NivLC/lava_jato/README.md

# Limpador ultrassônico

Esse projeto é um sistema de limpeza ultrassônica usando piezoelétricos para vibrar a água com frequência ajustável. O desenvolvimento foi divido em quatro etapas:

- [Etapa 1](./etapa_1/README.md) (10/09/2026): Fazer as pesquisas necessárias e dar início ao esquemático do projeto.
- [Etapa 2](./etapa_2/README.md) (01/10/2026): Projetar cada bloco de forma isolada, testá-los planejar a integração.
- [Etapa 3](./etapa_3/README.md) (05/11/2026): Desenvolvimento, montagem e teste do protótipo.
- [Etapa 4](./etapa_4/README.md) (10/12/2026): Ajustes finais para otimização.

## Requisitos

**(Adicionar aqui os requisitos de hardware e software.)**

Este projeto foi implementado com os seguintes módulos/softwares/hardwares:

- Sensor de temperatura PT100 com 3 fios.
- Sensor de corrente de efeito Hall LEM LA 205-S.
- Espressif IoT Development Framework (esp idf).
- Microcontrolador STM32F401.

## Visão geral

**(Adicionar aqui diagrama de blocos com UM parágrafo de explicação resumida de cada bloco (Ex.: 1 linha cada bloco).)**

**A figura deve estar com um tamanho adequado para melhorar a apresentação da página inicial do projeto.**

## Protótipo

**(Adicionar aqui uma foto do protótipo com UM parágrafo de explicação.)**

**A figura deve estar com um tamanho adequado para melhorar a apresentação da página inicial do projeto.**
