NivLC/lava_jato/etapa_2/README.md

# Etapa 2 - Design

Na etapa 2, objetiva-se:
- Detalhar a topologia escolhida na etapa 1;
- Caracterizar o piezoelétrico;
- Decidir Interface de controle;
    - Estudar possibilidade de trava de segurança;
- Definir design externo do recipiete;
- Escolher microcontrolador;
- Testes.

## Topologia 4: Fonte externa + Casamento de impedância

Por ser composta por um transformador *push-pull* que permite a conversão de energia através do casamento de impedância entre o primário e secundário, com apenas de duas chaves *low-side* para realizar a comutação, a topologia 4 é a mais adequada.  
Utilizando PWM e *timer*, o controle de potência é possível por tensão e/ou frequência, conforme Figuras 1 e 2.

<div align=center>
<h5>Figura 1: Topologia escolhida</h5>
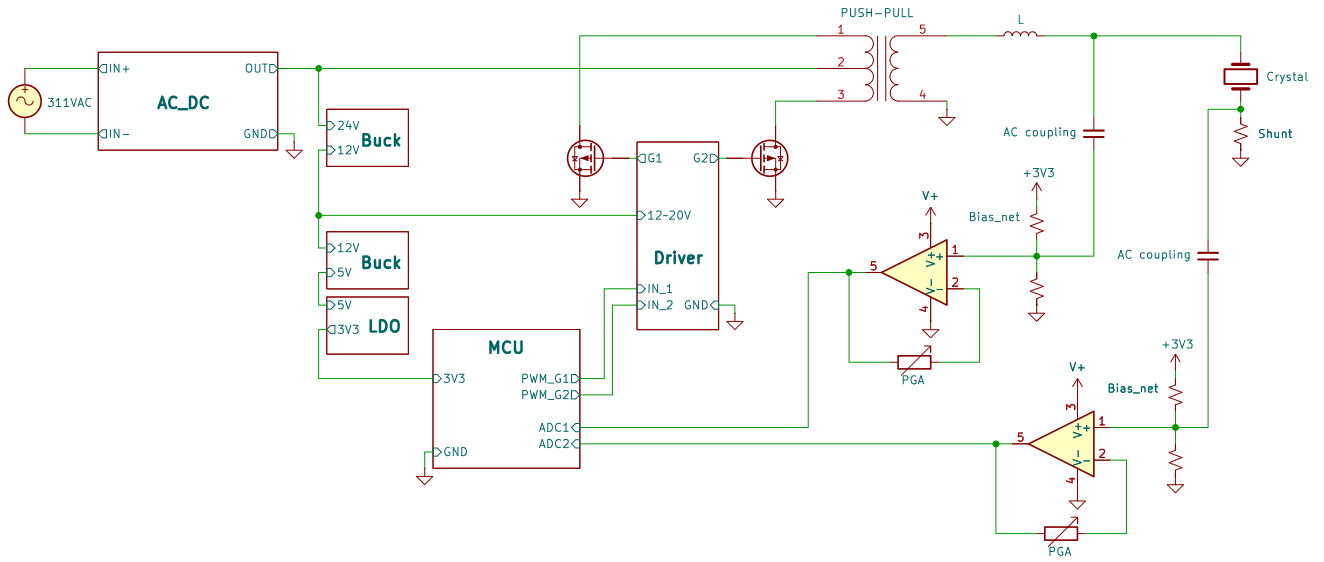
[picture p27: etapa_2/img/push-pull.png]

</div> <br>

<div align=center>
<h5>Figura 2: Timer e PWM</h5>
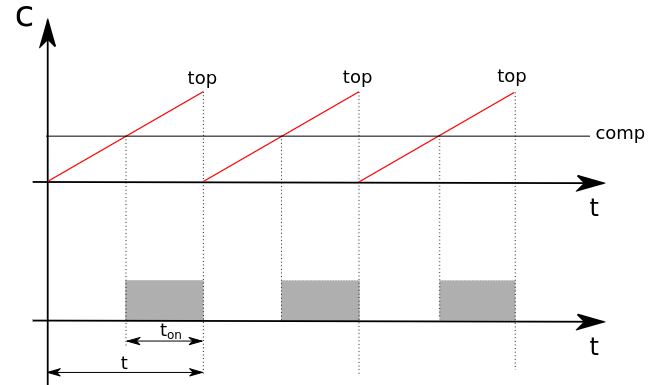
[picture p28: etapa_2/img/pwm-timer.png]

</div> <br><br>

O cristal pode ser considerado uma carga capacitiva. Com corrente constante, a tensão no capacitor é linear, portanto há um controle fino do movimento.

<div align=center>
<h5>Figura 3: Corrente constante X Tensão constante no capacitor</h5>
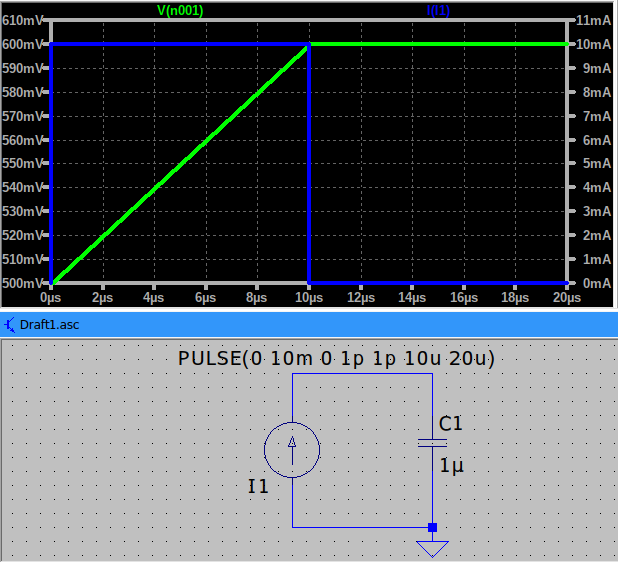
[picture p29: etapa_2/img/cap_curr.png]

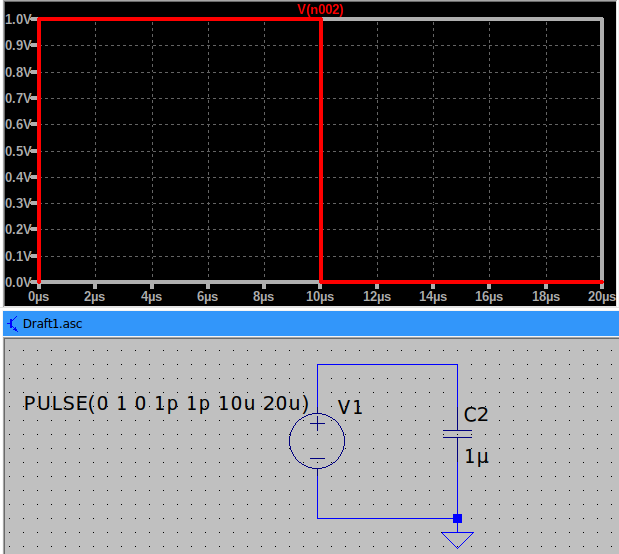
[picture p30: etapa_2/img/cap_volt.png]

</div> <br><br>

Como mencionado na Etapa 1, é possível adicionar um indutor em série no *tap* central do *push-pull* para fazer uma fonte de corrente. No entanto, o indutor tipicamente é grande e pode gerar picos de tensão altos na comutação das chaves.

Neste projeto, não há necessidade de controle fino da vibração, portanto podemos simplificar o projeto com fonte de tensão.

A fonte usada para a alimentação será de 24V/5A:

<div align=center>
<h5>Figura 4: Fonte externa</h5>
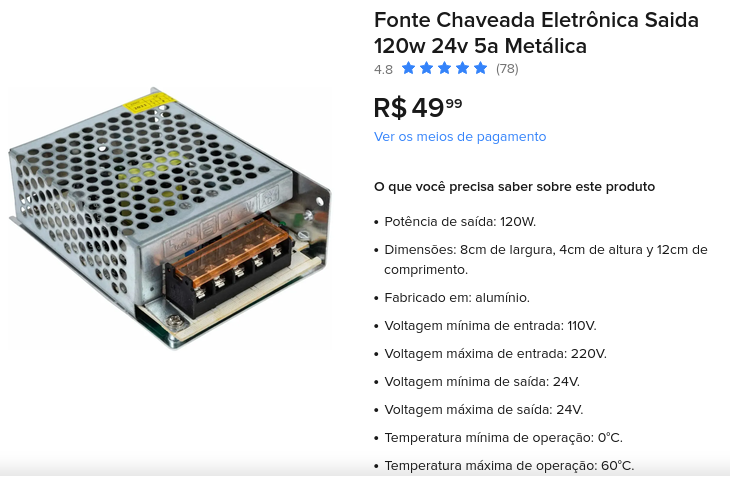
[picture p31: etapa_2/img/fonte.png]

</div> <br><br>

## Caracterização do cristal

Em um cristal piezoelétrico, o comportamento dinâmico é caracterizado por modos de vibração fundamentais: 
- Radial(planar): frequência governada pelo diâmetro, operando em faixas mais baixas (kHz);
- Axial(espessura): frequência governada pela espessura do componente, operando em frequências mais altas (MHz).

A tabela abaixo sumariza os modos de vibração e suas respectivas aplicações. Chamamos a atenção para "*Area expansion mode*" (radial) e "*Thickness expansion mode*" (axial).

<div align=center>
<h5>Figura 5: Modos de vibração do cristal</h5>
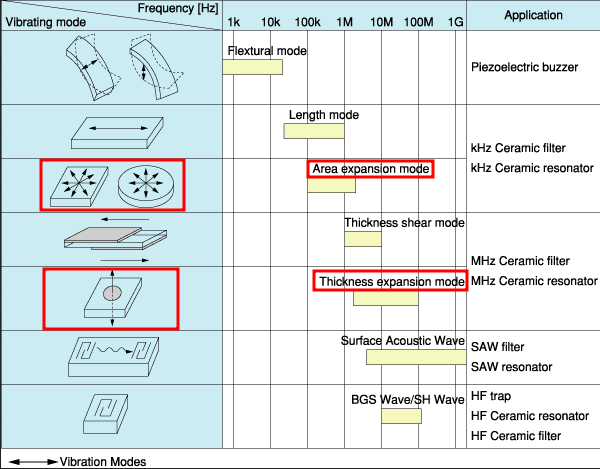
[picture p32: etapa_2/img/vibration.png]

</div> <br><br>

O modo que visamos trabalhar é o **radial**. O modo axial, por conta de sua frequência de operação muito elevada, é melhor aproveitado em aplicações como atomizadores e umidificadores.

Para caracterizar o cristal, utilizamos um osciloscópio com o seguinte *setup*:

<div align=center>
<h5>Figura 6: Diagrama de conexões para caracterizar o cristal</h5>
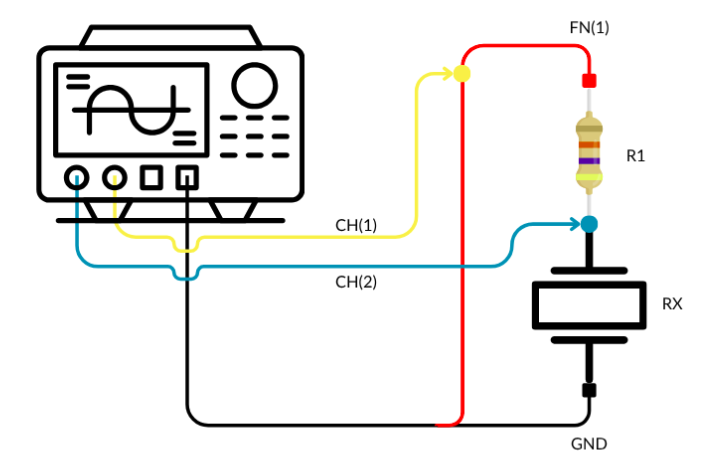
[picture p33: etapa_2/img/caracterizacao.png]

</div> <br><br>

Para equilibrar o divisor de tensão, usamos resistores próximos a impedância estimada do cristal.

O fabricante garante que o cristal tem uma impedância de ressonância inferior a $20 \Omega$, portanto, usamos resistores de $51.2 \Omega$ e $3279 \Omega$ para encontrar, respectivamente, a impedância de ressonância e anti-ressonância em ambos os modos axial e radial de acordo com a fórmula do divisor de tensão:

$$ V_{CH2} = V_{CH1} \frac{R_{cristal}}{R_{cristal} + R1} $$
<br>

### Cristal em aberto

#### Frequências do cristal

Primeiramente, obtivemos informações de frequência apenas com o resistor de $51.2 \Omega$ conectado, sem o cristal. Assim, podemos observar a influência do componente na medição do cristal.

>OBS: Há alguns momentos em que a medição no osciloscópio falha, ocasionando vales bruscos não característicos do sistema real. Essas medições estão identificadas como "nan" nos arquivos .csv disponíveis em [hardware/bode](etapa_2/hardware/bode).

<div align=center>
<h5>Figura 7: Bode Plot com cristal desconectado</h5>
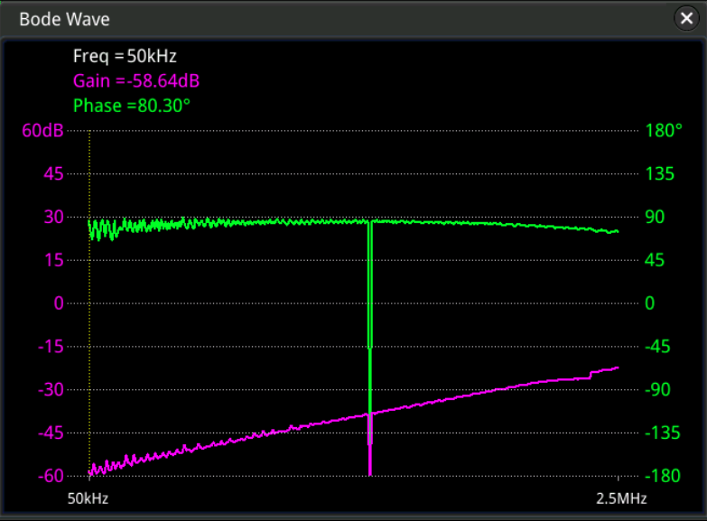
[picture p34: etapa_2/img/setup_bode.png]

</div><br>

Exceto pelo erro de medição, o resistor não aparenta influenciar em demasia o sistema.

Agora,  as informações de frequência para cada resistor.

- Resistor de $3179 \Omega$

    <div align=center>
    <h5>Figura 8: Bode Plot de banda completa</h5>
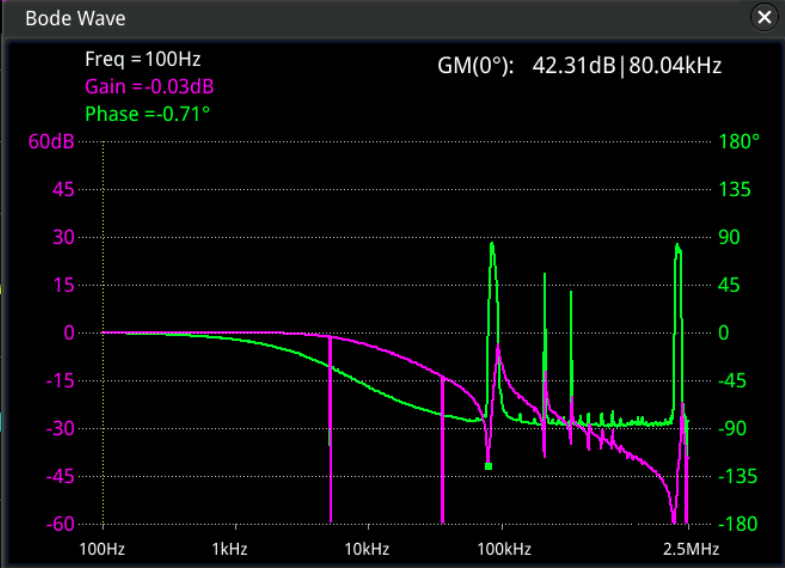
[picture p35: etapa_2/img/R3k_bode_full.png]
    
    </div>

    <div align=center>
    <h5>Figura 9: Bode Plot com zoom no modo axial</h5>
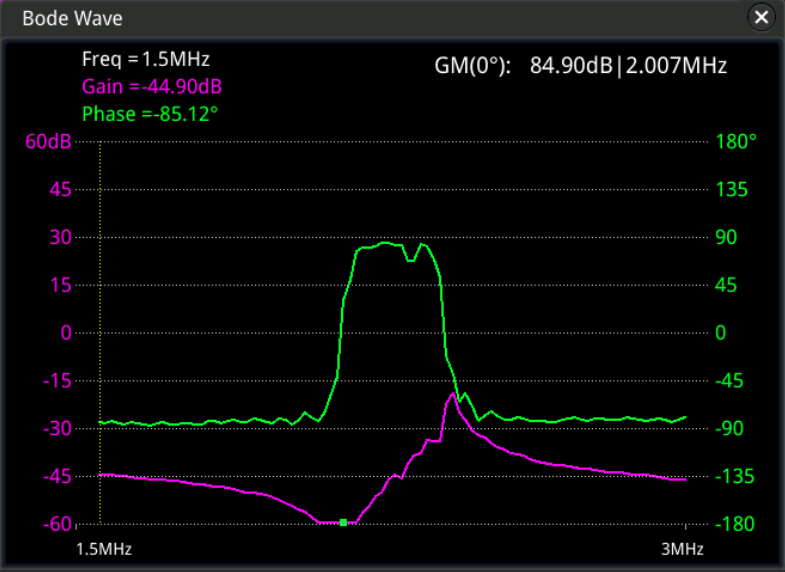
[picture p36: etapa_2/img/R3k_axial_bode.png]
    
    </div>

    <div align=center>
    <h5>Figura 10: Bode Plot com zoom no modo radial</h5>
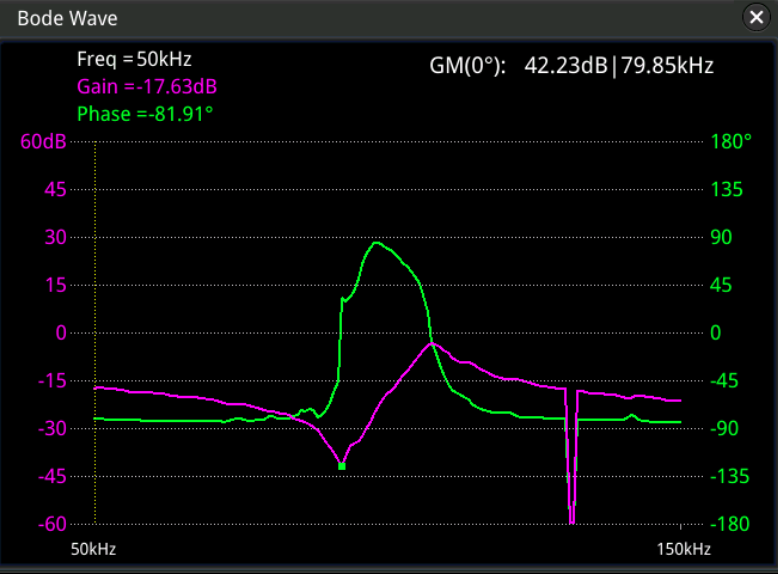
[picture p37: etapa_2/img/R3k_radial_bode.png]
    
    </div>

<br>

- Resistor de $51.2 \Omega$

    <div align=center>
    <h5>Figura 11: Bode Plot de banda completa</h5>
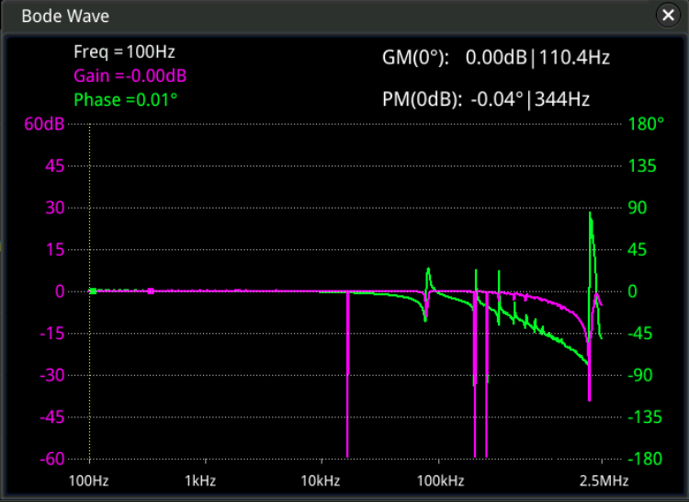
[picture p38: etapa_2/img/R51_bode_full.png]
    
    </div>

    <div align=center>
    <h5>Figura 12: Bode Plot com zoom no modo axial</h5>
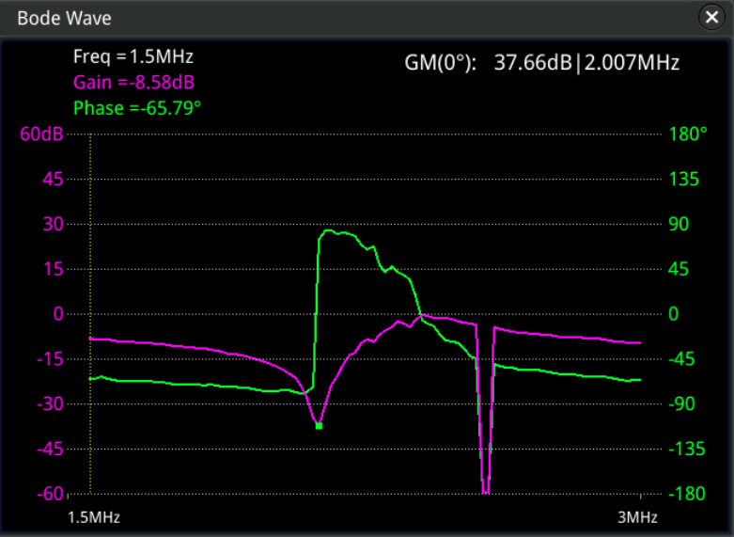
[picture p39: etapa_2/img/R51_axial_bode.png]
    
    </div>

    <div align=center>
    <h5>Figura 13: Bode Plot com zoom no modo radial</h5>
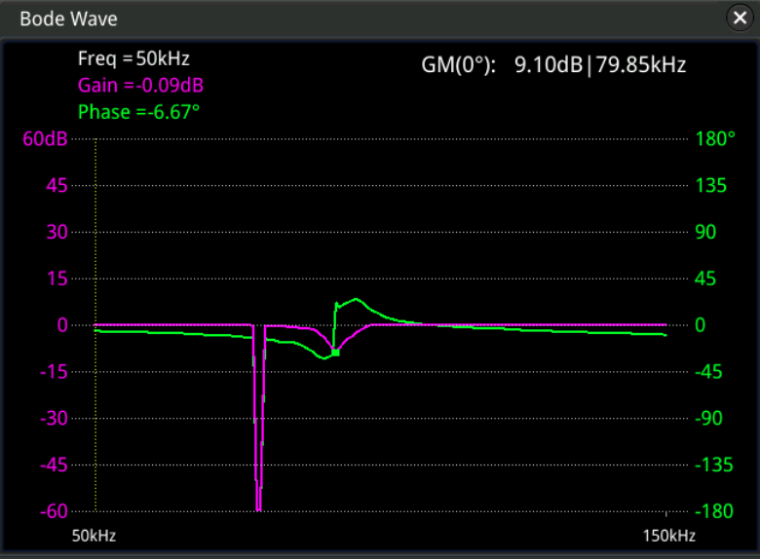
[picture p40: etapa_2/img/R51_radial_bode.png]
    
    </div>

#### Impedância do cristal

Obtendo os valores de $V_{CH1}$ (Vamp1) e $V_{CH2}$ (Vamp2) pelo osciloscópio:

<div align=center>
<h5>Figura 14: Resistor de 51.2Ω (Modo AXIAL)</h5>
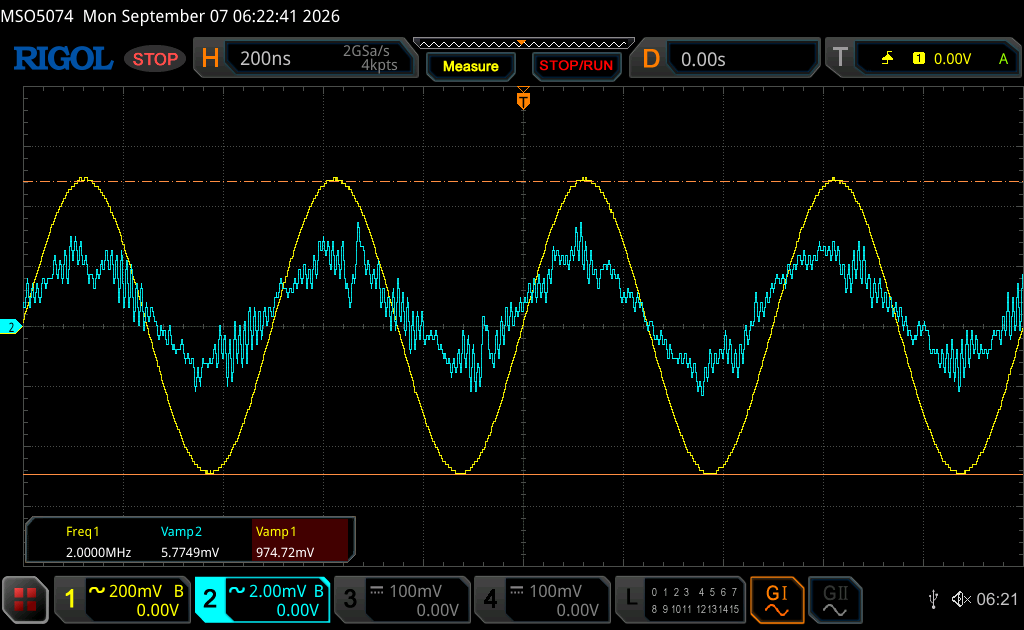
[picture p41: etapa_2/img/R51_axial.png]

</div>

<div align=center>
<h5>Figura 15: Resistor de 51.2Ω (Modo RADIAL)</h5>
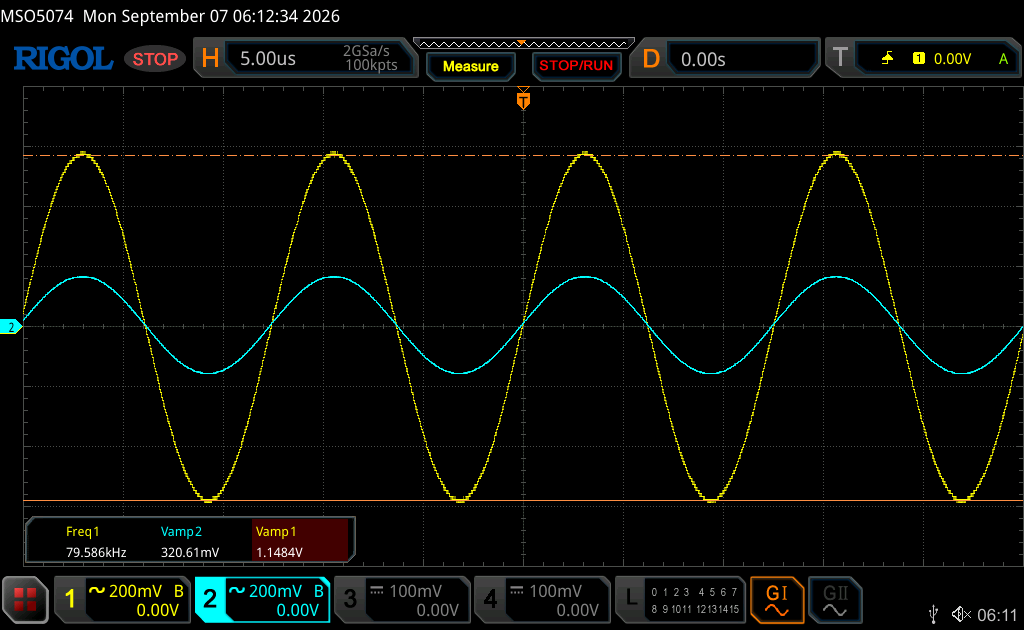
[picture p42: etapa_2/img/R51_radial.png]

</div>

<div align=center>
<h5>Figura 16: Resistor de 3279Ω (Modo AXIAL)</h5>
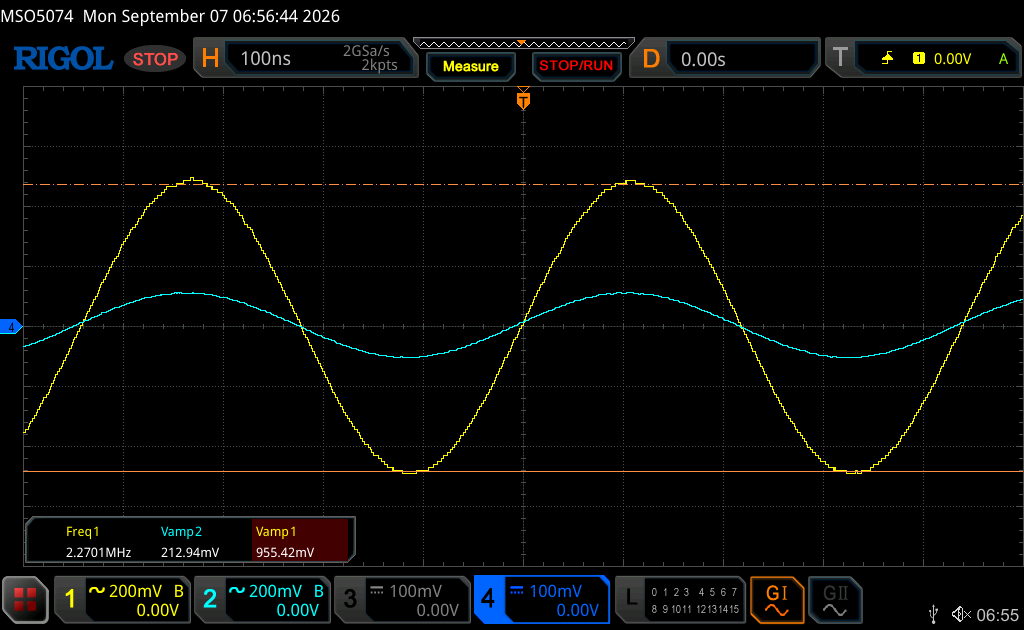
[picture p43: etapa_2/img/R3k_axial.png]

</div>

<div align=center>
<h5>Figura 17: Resistor de 3279Ω (Modo RADIAL)</h5>
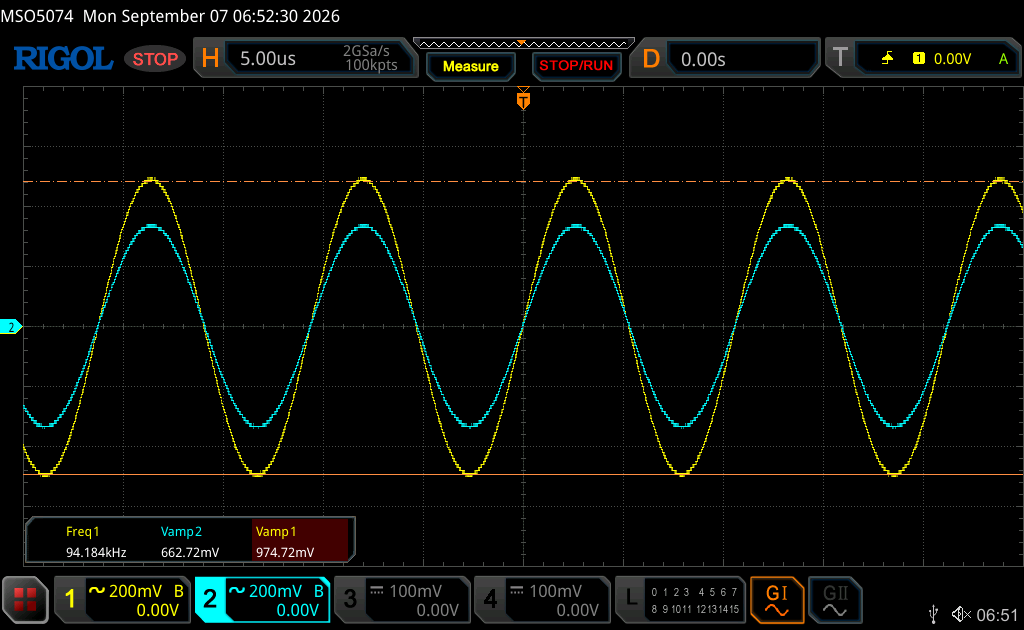
[picture p44: etapa_2/img/R3k_radial.png]

</div><br><br>

Com os valores de tensão conhecidos, podemos calcular o divisor de tensão para $R_{\mathrm{cristal}}$.

### Modo AXIAL

**Ressonância**

$$
0.0057744 = 0.97472 \cdot
\frac{R_{\mathrm{cristal}}}{R_{\mathrm{cristal}} + 51.2}
\qquad \rightarrow \qquad
R_{\mathrm{cristal}} = 0.305\ \Omega
$$

**Anti-ressonância**

$$
0.21294 = 0.95542 \cdot
\frac{R_{\mathrm{cristal}}}{R_{\mathrm{cristal}} + 3279}
\qquad \rightarrow \qquad
R_{\mathrm{cristal}} = 940.402\ \Omega
$$

### Modo RADIAL

**Ressonância**

$$
0.32061 = 1.1484 \cdot
\frac{R_{\mathrm{cristal}}}{R_{\mathrm{cristal}} + 51.2}
\qquad \rightarrow \qquad
R_{\mathrm{cristal}} = 19.8301\ \Omega
$$

**Anti-ressonância**

$$
0.66272 = 0.97472 \cdot
\frac{R_{\mathrm{cristal}}}{R_{\mathrm{cristal}} + 3279}
\qquad \rightarrow \qquad
R_{\mathrm{cristal}} = 6964.93\ \Omega
$$

#### Capacitância

O fabricante disponibiliza uma tabela de valores padrão para o cristal dependendo do tamanho.

O valor da capacitância de placa padrão é de $6940 \pm 15 \% \text{ pF}$. Este valor condiz com o medido com multímetro, de aproximadamente $6.241 \text{ nF}$.

<div align=center>
<h5>Figura 18: Informações do fabricante</h5>
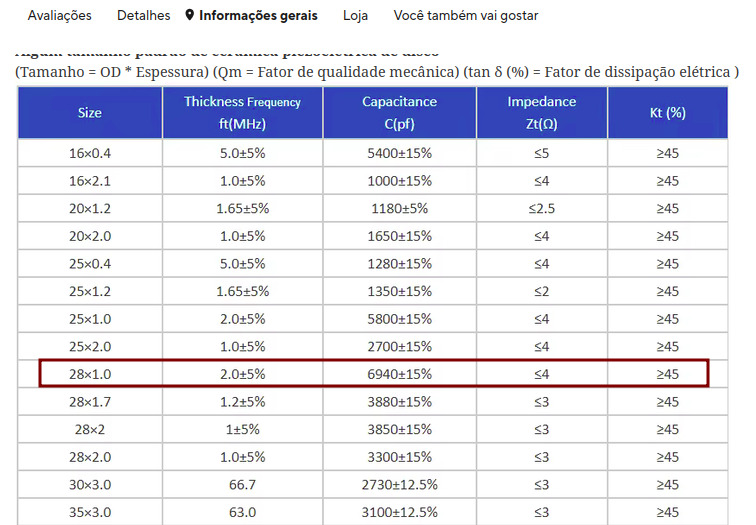
[picture p45: etapa_2/img/fabricante.jpeg]

</div> <br><br>

#### Resultados

Para o modo radial, temos os seguintes resultados:

| Parâmetro | Valor |
|:---|:---|
| Ressonância | 79.85 kHz |
| Anti-ressonância | 94.54 kHz |
| Impedância na ressonância | 19.8301Ω |
| Impedância na anti-ressonância | 6964.93Ω |
| Capacitância de placa | 6.241 nF |

## Interface de controle

Para a interface de controle, optou-se por utilizar um *encoder* rotativo em conjunto com um display(OLED SSD1306 128x64 5V), que servirão de base para a interface humano-máquina.

### Trava de segurança

A resistência mecânica ao movimento do piezoelétrico gera uma variação na impedância enxergada pela corrente que passa por ele, o que leva a uma variável incômoda: a corrente será maior do que o esperado se a bacia estiver vazia, o que pode queimar o transdutor. Uma simples tela de confirmação é o suficiente para garantir que o usuário não ligue o sistema sem água na bacia. Uma mensagem deverá aparecer para o usuário confirmar que a bacia está cheia e que o usuário gostaria de prosseguir ou se deseja cancelar a operação.

## Design externo do recipiente

A cuba interna precisa ser de INOX, e é mostrada na **Figura 19**.

<div align=center>
<h5>Figura 19: Tela em fibra de vidro</h5>
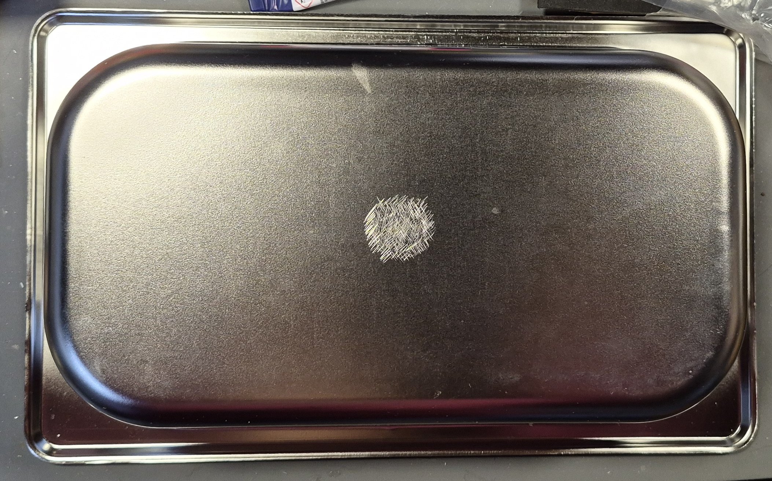
[picture p46: etapa_2/img/fixacao.jpeg]

</div><br>

Já a cestinha interna deve ser vazada, com área de abertura suficiente para que a onda ultrassônica, propagando-se na água, consiga atravessar. Além disso, encontrar uma cestinha inox que se ajuste à nossa cuba é um empecilho grande.  
O comprimento de onda é dado por:

$\lambda=c/f$ ,    c a velocidade da onda na água  
$\lambda=1500/40k$  
$\lambda=37,5 mm$  

Considerando essas informações, decidiu-se fabricar a cestinha a partir da tela mostrada na **Figura 21**, feita em fibra de vidro revestida por teflon.

<div align=center>
<h5>Figura 20: Tela em fibra de vidro</h5>
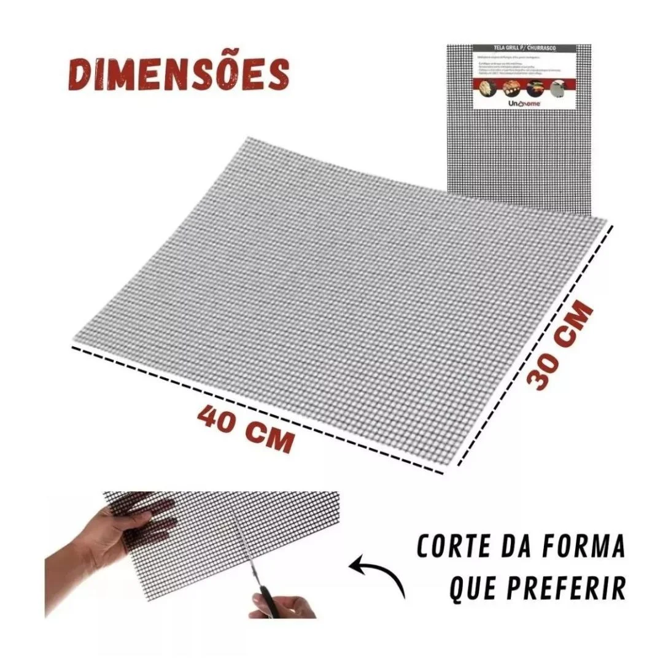
[picture p47: etapa_2/img/tela.webp]

</div><br>

Onde o vão da tela é de $4mm$, ~9 vezes menor que o $\lambda$. Além disso, optou-se por fabricar a carenagem externa impressa em 3D, levando-se em consideração a interface de controle decidida anteriormente.

## Escolha do embarcado

A seguinte tabela resume a análise de requisitos, comparando diferentes microcontroladores:

<div align=center>
<h5>Figura 21: Comparação entre microcontroladores</h5>
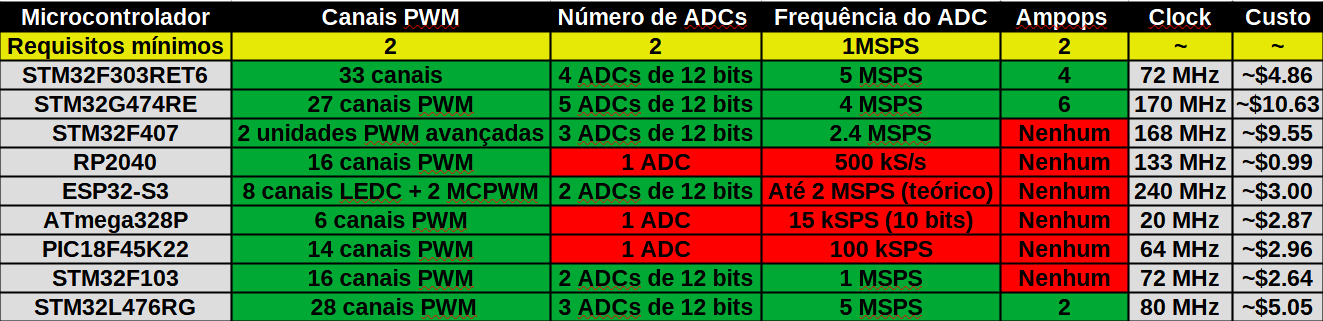
[picture p48: etapa_2/img/microcontrolador.png]

</div><br>

O requisito de frequência de amostragem foi obtido com base no critério de Nyquist(2~4x maior que a de comutação).  
O embarcado escolhido para esta aplicação foi o **STM32F303RET6**, possuindo:

- 4 ADCs de 0.14 MHz a 72 MHz;
- 4 AMPOPs internos.

<div align=center>
<h5>Figura 22: Microcontrolador escolhido</h5>
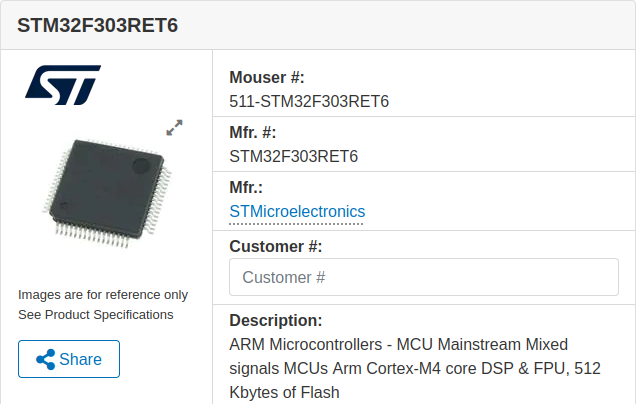
[picture p49: etapa_2/img/stm.png]

</div>

<div align=center>
<h5>Figura 23: Features do microcontrolador</h5>

</div>

## Testes

Para a realização dos testes, foi fabricada uma PCB. A documentação detalhada se encontra em [hardware/README.md](etapa_2/hardware/README.md).

### *Display* e *encoder*

O teste feito usa o *encoder* para incrementar/decrementar um contador, enquanto uma bola quica. Ao pressionar o botão, a cor do *display* muda e a bola sofre uma força de sentido contrário.

O código está disponível em [software](etapa_2/software).

<div align=center>
<h5>Figura 24: Teste display + encoder</h5>

</div>

### Configuração de *timer* e PWM (Sem *driver*)

Para o teste, seguimos a seguinte configuração do TIMER 1 com ARR = 1440:

| Channel | Mode | CCR/Pulse |
| --- | --- | ---: |
| CH1 | Combined PWM1 | 0 |
| CH2 | PWM1 (No output) | 500 |
| CH3 | Combined PWM1 | 720 |
| CH4 | PWM1 (No output) | 1220 |

<br>
<div align=center>
<h5>Figura 25: Combined PWM Mode 1</h5>

</div><br>

No modo *Combined PWM mode 1*, o referência é o OR dos sinais PWM, ou seja, o maior valor entre os canais. Neste caso, CH1|CH2 e CH3|CH4. 
Para calcular o *duty cycle*:

- CH1 | CH2

$$ D = \frac{CCR_{max}}{ARR} \qquad \rightarrow \qquad D = \frac{500}{1440} \approx 34.7\% $$

<br>
<div align=center>
<h5>Figura 26: Duty do CH1</h5>
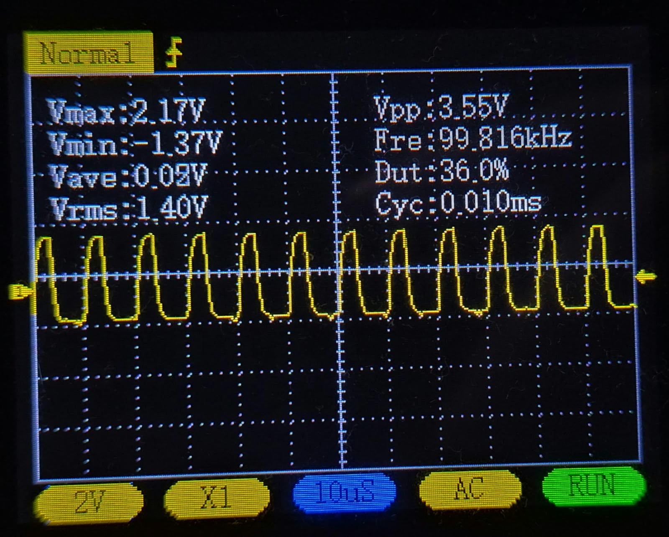
[picture p50: etapa_2/img/duty.jpeg]

</div><br><br>

- CH3 | CH3

$$ D = \frac{CCR_{max}}{ARR}\qquad \rightarrow \qquad D = \frac{1220}{1440} \approx 84.7 \% $$

<br>
<div align=center>
<h5>Figura 27: Duty do CH2</h5>
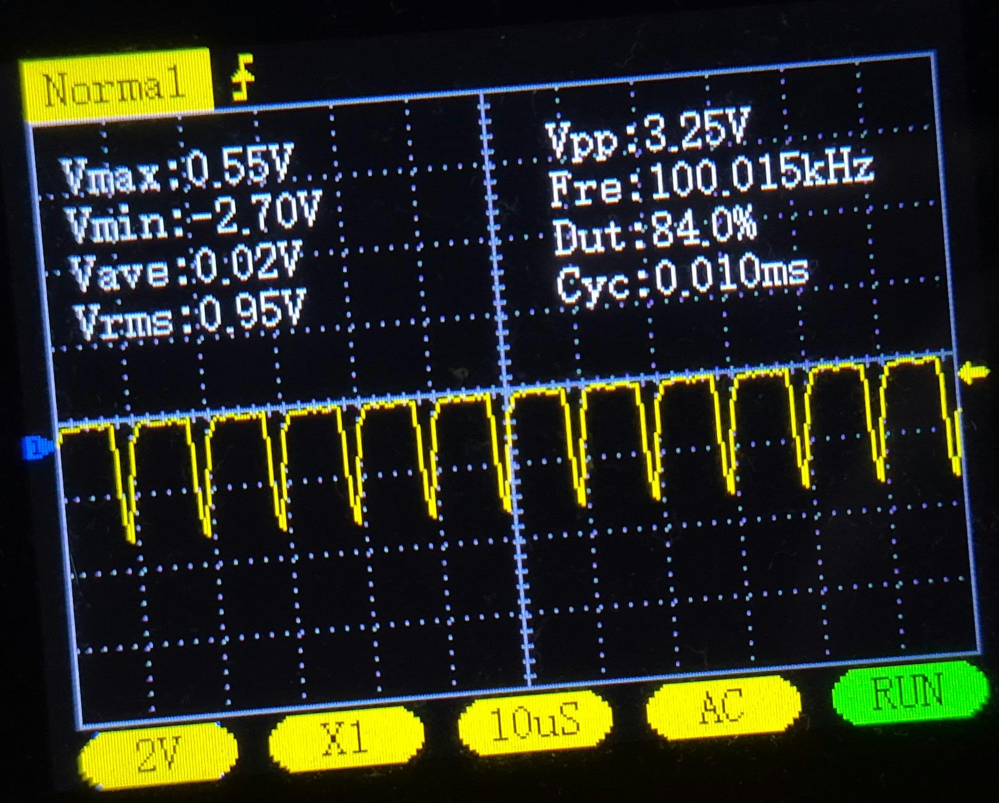
[picture p51: etapa_2/img/duty1.jpeg]

</div><br><br>

A partir da medição de frequência do osciloscópio podemos validar também o funcionamento do *timer*:

$$ f = \frac{f_{timer}}{ARR} = \frac{144 MHz}{1440} = 100 kHz $$

## Referências

- [YUNYISONIC: What Influences Ultrasonic Cleaning Effectiveness](https://www.yunyisonic.com/what-influences-ultrasonic-cleaning-effectiveness/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)
- [Ultrasonic Cleaner Sweep Mode | Tovatech ](https://www.youtube.com/watch?v=2wetLSvoQwQ)
- [Ceramic Resonators (CERALOCK): Vibration Modes](https://www.murata.com/products/timingdevice/ceralock/overview/basic/vibration)
- RM0316 Reference manual
