NivLC/lava_jato/etapa_3/especificacao_fundamentacao.md

# Fundamentação teórica
Levando em conta o volume de informações necessárias na etapa 3, torna-se necessário a criação deste material de apoio.

## Especificações de Projeto

### Potência de trabalho, superdimensionamento e fatores de segurança:

Razão potência-tanque usual:  
$8$ a $15W/L$;
 
O que temos:  
- Potência do piezo: $35W$  
- Volume do recipiente: $1,3L$  
- Faixa de potência: $10,4 \,a \,19,5W$  

Com o intuito de trabalharmos com folga e ter a oportunidade de testar os limites da limpadora, optou-se por superdimensionar a potência($30W$), deixando para controlar o limite desejado via software: 
> Obs: A resistência de ressônancia do pizoelétrico mudou para $324 \Omega$ com a bacia acoplada. 

A relação de espiras é dada na **Figura 1**.

<div align=center>
<h5>Figura 1: Cálculo da relação de espiras</h5>
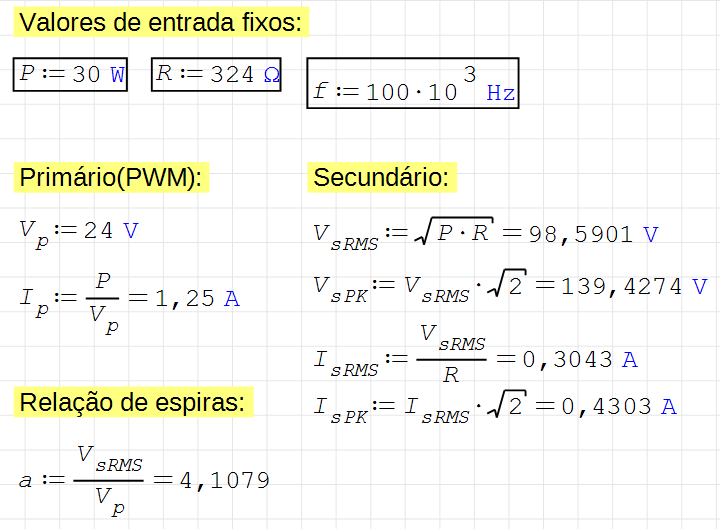
[picture p85: etapa_3/img/relacao_espiras.png]

</div> <br>

Parâmetros de segurança:

A profundidade pelicular $\delta$ é dada por

$$
\delta = \sqrt{\frac{\rho}{\pi f \mu}}
$$

Onde:
- $\delta$ = Profundidade pelicular $m$
- $\rho$ = Resistividade do material ($\Omega \cdot m$)
- $f$ = Frequência ($Hz$)
- $\mu = \mu_0 \mu_r =$ Permeabilidade magnética absoluta ($H/m$)

A aproximação prática é:

$$
\delta_{Cu} \approx \frac{75}{\sqrt{f}} \quad [\text{mm}]
$$

- Profundidade pelicular para o pior caso($100kHz$): $\delta \approx 0,2372mm$
- Densidade de corrente segura: $J \geq 3 \, \text{A/mm}^2$  

### Caracterização do núcleo:

O núcleo foi obtido de um transformador da série ERL35, com as seguintes características disponíveis:  

**Núcleo:** ETD (formato "E" duplo, com cilindro central).  
**Área da Seção Transversal Efetiva ($A_e$):** $107mm^2$. Esta área define o fluxo magnético máximo antes da saturação.  

Algumas especificações referentes ao núcleo são obtidas de forma empírica: 

#### Fator de indutância $A_L$:

<br>Através da equação genérica da indutância:

$$
L = \frac{\mu_0 \mu_r N^2 A_e}{l_e} = \left(\frac{\mu_0 \mu_r A_e}{l_e}\right)N^2
$$

$$
A_L = \frac{L}{N^2} = \frac{\mu_0 \mu_r A_e}{l_e}
$$

Onde:
- $A_L$ = fator de indutância $[\mu H/espiras^2]$(*dependente apenas das características do núcleo*);
- $\mu_0$ = permeabilidade do vácuo;
- $\mu_r$ = permeabilidade relativa;
- $N$ = espiras;
- $A_e$ = área efetiva da seção transversal;
- $l_e$ = comprimento efetivo do caminho magnético;
- $L$ = indutância característica da bobina.

$A_L$ pode ser inferido através da indutância de magnetização, que é obtida de duas formas, por uma configuração tanque LC, conforme as figuras abaixo, ou ainda, através de uma ponte LCR.  <br>

<div align=center>
<h5>Figura 2 - Caracterização do núcleo</h5>
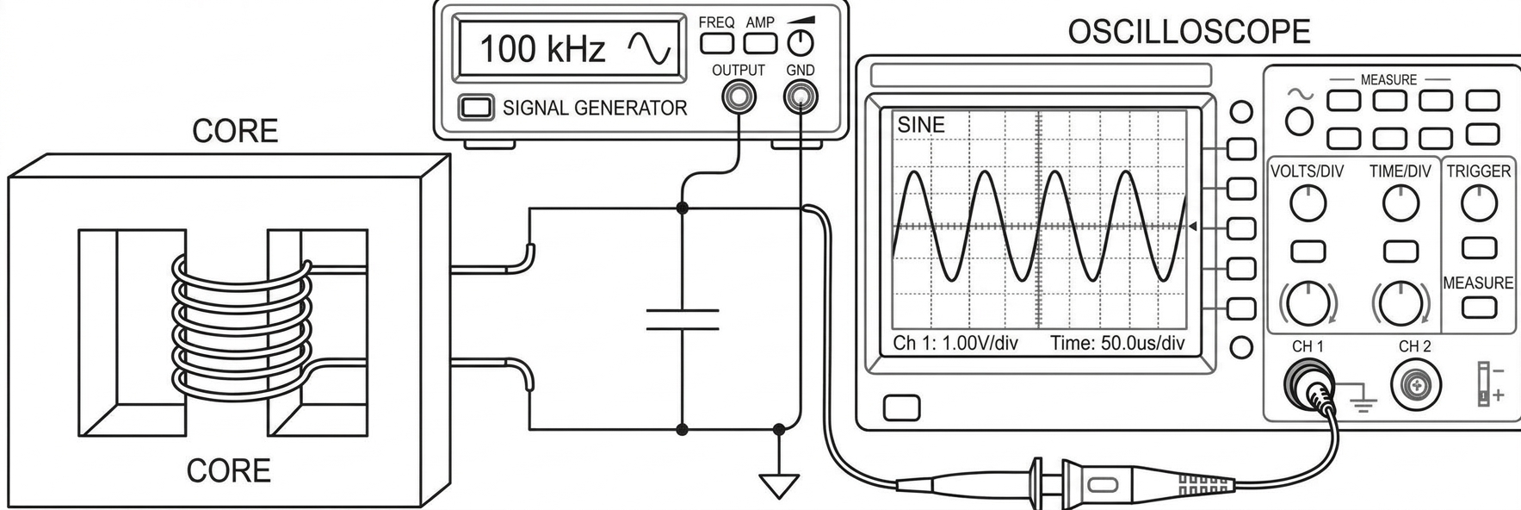
[picture p86: etapa_3/img/core_setup.jpeg]

</div> <br><br>

<div align=center>
<h5>Figura 3 - Caracterização do núcleo 2</h5>
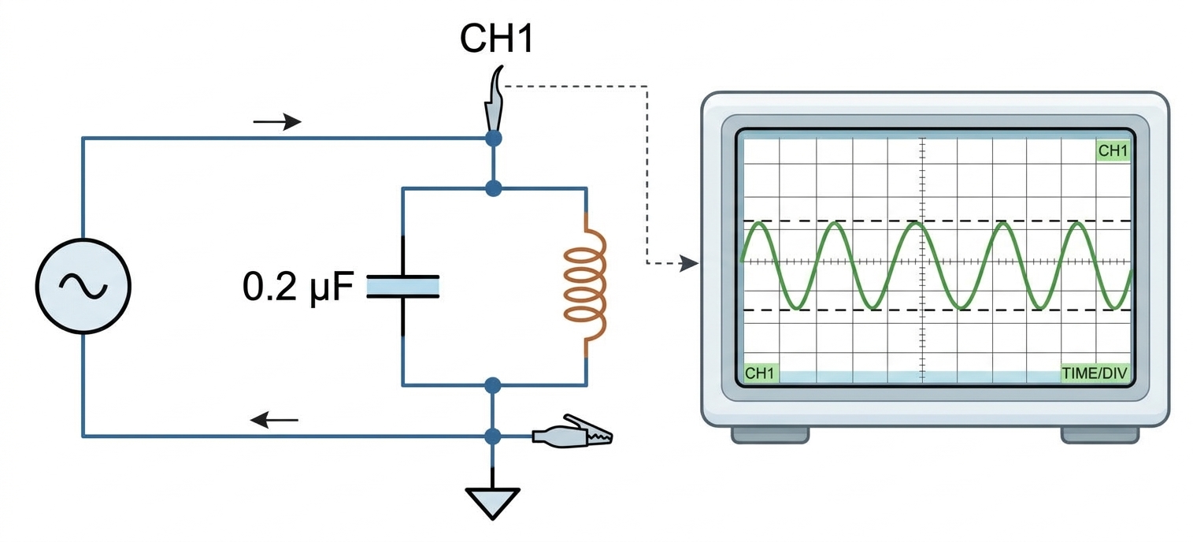
[picture p87: etapa_3/img/tanque_LC.jpeg]

</div> <br><br>

Com C conhecido, varia-se a frequência do sinal até encontrar a frquência de ressonância, onde a tenção é máxima:

$$
f = \frac{1}{2\pi\sqrt{LC}} \Rightarrow L = \frac{1}{(2\pi f)^2 C}
$$

Ainda, conhecendo o número de espiras, também é possível encontrar $A_L$ pela ponte LCR, conforme figura abaixo:

<div align=center>
<h5>Figura 4 - Medição de L através da ponte LCR</h5>
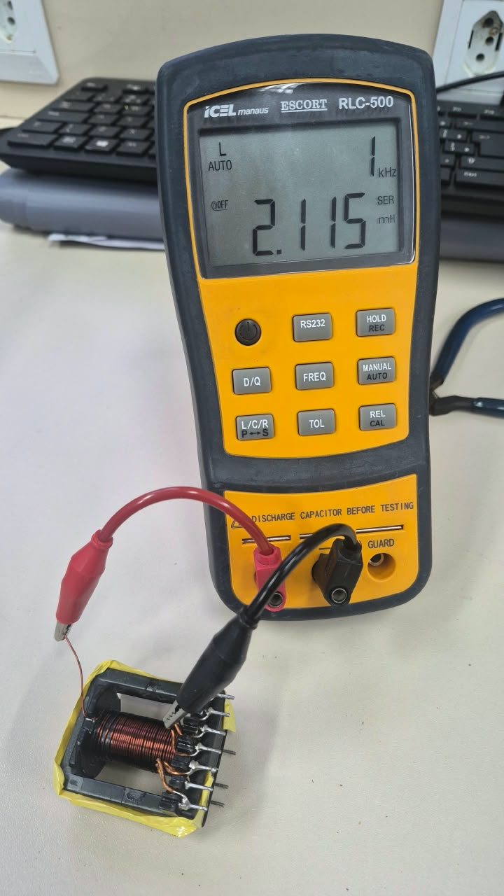
[picture p88: etapa_3/img/ponte_lcr.jpeg]

</div> <br><br>

Portanto:
$$
A_L = \frac{2,115m \,H}{34^2} = 0,46\mu \,H/espiras^2
$$

#### Área da Seção Transversal Efetiva ($A_e$) e Área da Janela do Carretel ($A_w$)

Através do datasheet do transformador, obten-se $A_e$ e $A_w$, conforme a **Figura 5**:  

<div align=center>
<h5>Figura 5 - Diâmetro do núcleo</h5>
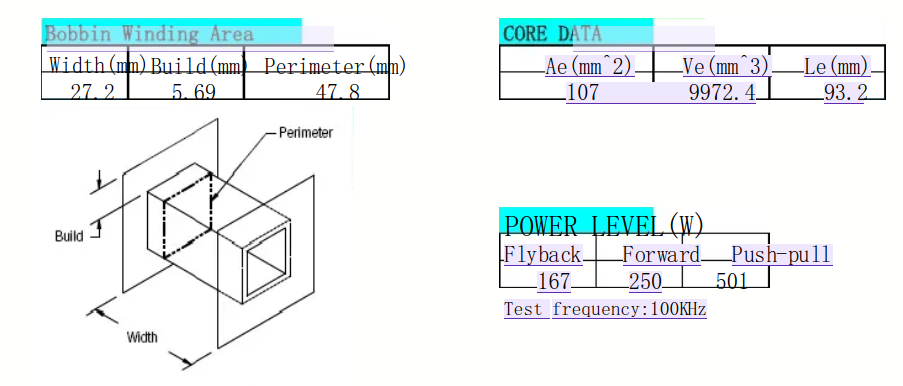
[picture p89: etapa_3/img/nucleo_dim.png]

</div> <br><br>

$$A_e = 107mm^2 $$
$$
A_w = l \cdot h = 27,2 \cdot 5,69 = 154,8 mm^2
$$

## Dimensionamento da Bitola dos Cabos

$$A = \pi r^2 \text{ e } J = I/A$$
Com um pouco de algebrismo e evidenciando $D$, obten-se a **Bitola teórica**:
$$ D_{teórica} = 2 \sqrt{\frac{I}{J\pi}} $$
<br>

Levando em consideração a profundidade pelicular($\delta$), temos como regra prática: 

$$D_{elementear} \leq 2\delta$$

Assim, escolhe-se uma bitola que respeite essa regra. Nesse caso, optou-se por $D_{elementar}=0,405mm$, fio **AWG 26**.

O número de cabos bifilares $N$ é obtido ao dividir a área da bitola teórica pela área da bitola elementar efetiva:  

$$N=\frac{A_{teórica}}{A_{elementear}}$$

$$N=\frac{4\pi D_{teórica}^2}{4\pi D_{elementear}^2}=\frac{D_{teórica}^2}{D_{elementear}^2}
$$

$$N_{pri}=3,2344$$
$$N_{sec}=0,7873$$

<br>

Por margem de segurança, escolheu-se usar $N_{pri}=4$ e $N_{sec}=1$.

## Dimensionamento das espiras

O número de espiras do primário é obtido pela lei de Faraday:

$$
V_{max}(t) = N \frac{d\Phi_{max}}{dt}
\quad\Longrightarrow\quad
\int V(t)\,dt = N \Delta \Phi_{max}
$$

Para uma onda quadrada, chegamos no módulo da tensão autoinduzida:

$$
V_{rms}= V_{pico} = 4 f N A_e B_{max} = V_{pico} = \frac{4 N A_e B_{max}}{t_{on}}
$$

$$
N = \frac{V_{max}t_{on}}{4B_{max}A_e}
$$

Onde:
- $N$: número de espiras do indutor;
- $V_{pri}$: tensão aplicada em **metade** do primário;
- $t_{on}=TD$: tempo efetivo de condução, onde T é o período de onda, e D o duty cycle;
- $B$: densidade de fluxo magnético de projeto (com margem de segurança em relação ao $B_{max}$ do material)
- $A_e$: área da seção transversal efetiva do núcleo

.: A saturação do núcleo depende do produto tensão-tempo aplicado ao enrolamento (volt-segundo). O pior caso ocorre quando a tensão de entrada é máxima e o tempo de condução é máximo (50% de dutycicle).

**Primário**:

$$
N_P = \frac{V_Pt_{on}}{4B_{max}A_e}
$$

**Secundário:** 

Pela relação de transformação do conversor push-pull:

$$
\frac{V_S}{V_P} = 2 \, \frac{N_S}{N_P}D
$$

$$
N_S = \frac{1}{2} \left( \frac{V_S}{V_P} \right) \left( \frac{N_P}{D} \right)
$$

**Corrente de magnetização**:

Através da Lei de Faraday aplicada a um indutor, temos:

$$V=L\cdot di/dt$$

Por se tratar de um push-pull, $1/dt=1/\Delta T=2f$, logo:

$$\Delta i_{mag}=\frac{V_p\cdot\frac{1}{2f}}{L_{mag}}$$

<br>

Juntando todas essas equações, constrói-se uma tabela, analisa-se os valores, escolhe-se um número de espiras para o primário e secundário, simula-se o circuito e, por fim, fabrica-se o trafo. Na **Figura 6**, a tabela calculada.

<div align=center>
<h5>Figura 6 - Tabela de dimensionamento do trafo</h5>

</div> <br><br>

A ferramenta de cálculo usada foi o Smath, e o arquivo de projeto pode ser encontrado [aqui](/etapa_3/hardware/trafo).
