NivLC/lava_jato/etapa_1/img/freq_bubbles.png

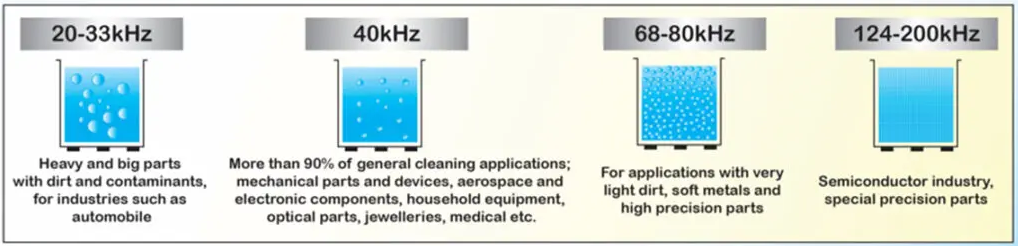
etapa_1/img/freq_bubbles.png
