NivLC/lava_jato/etapa_1/img/principle.png

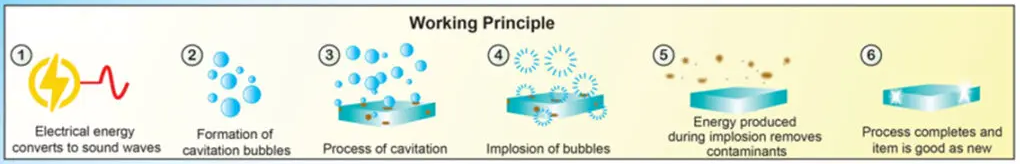
etapa_1/img/principle.png
