NivLC/lava_jato/etapa_2/img/cap.png

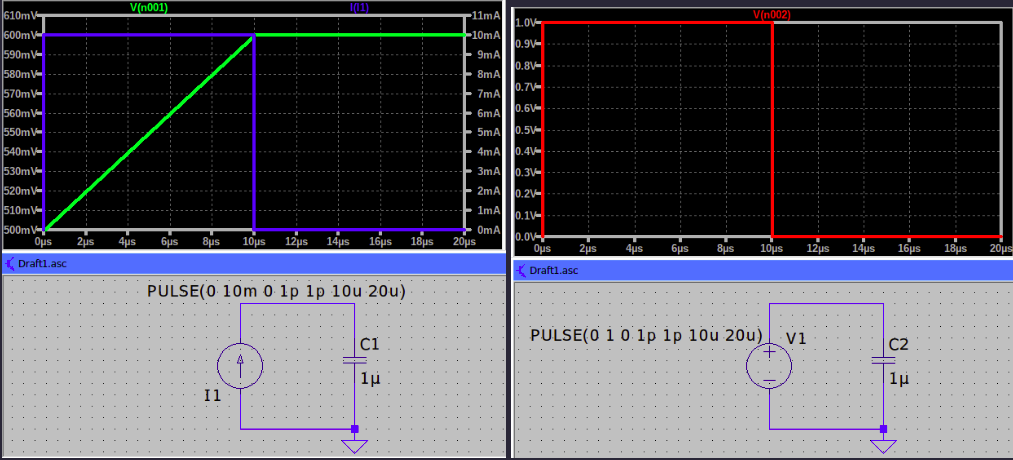
etapa_2/img/cap.png
