NivLC/lava_jato/etapa_2/img/caracterizacao1.png

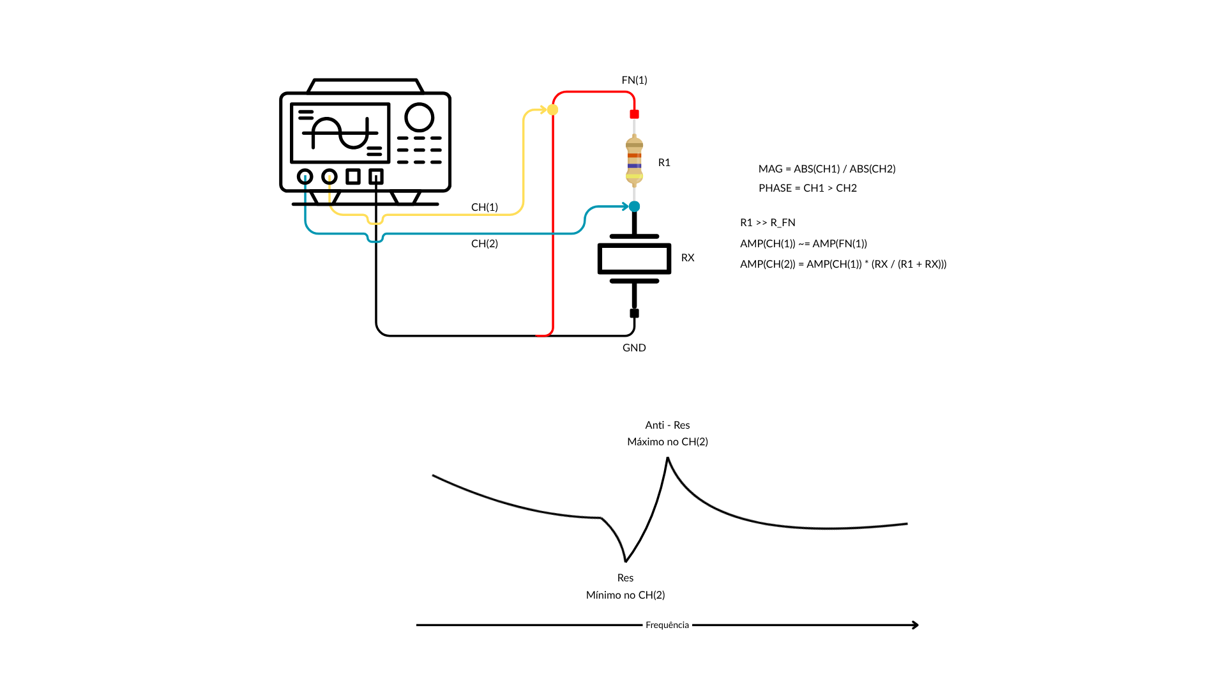
etapa_2/img/caracterizacao1.png
