NivLC/lava_jato/etapa_2/img/fixacao2.jpeg

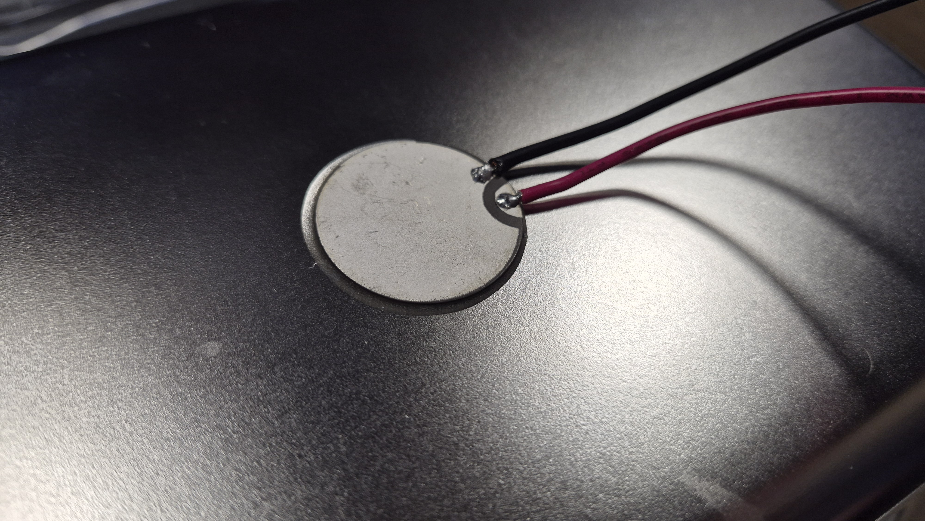
etapa_2/img/fixacao2.jpeg
