NivLC/lava_jato/etapa_2/img/fixacao3.jpeg

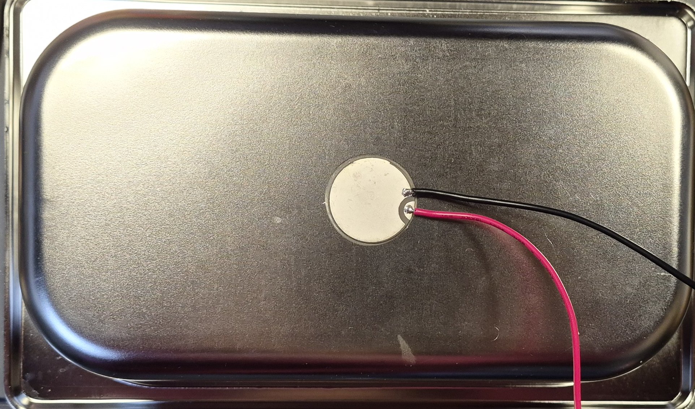
etapa_2/img/fixacao3.jpeg
