NivLC/lava_jato/etapa_3/img/corrente_primario.jpeg

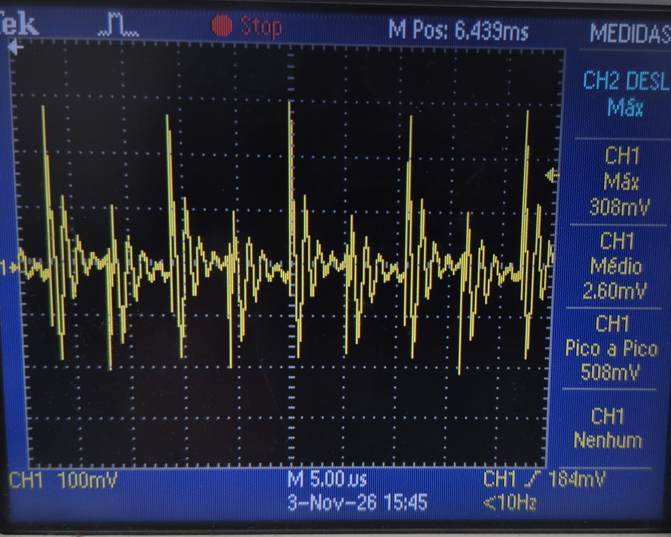
etapa_3/img/corrente_primario.jpeg
