NivLC/lava_jato/etapa_3/img/diagrama_driver.png

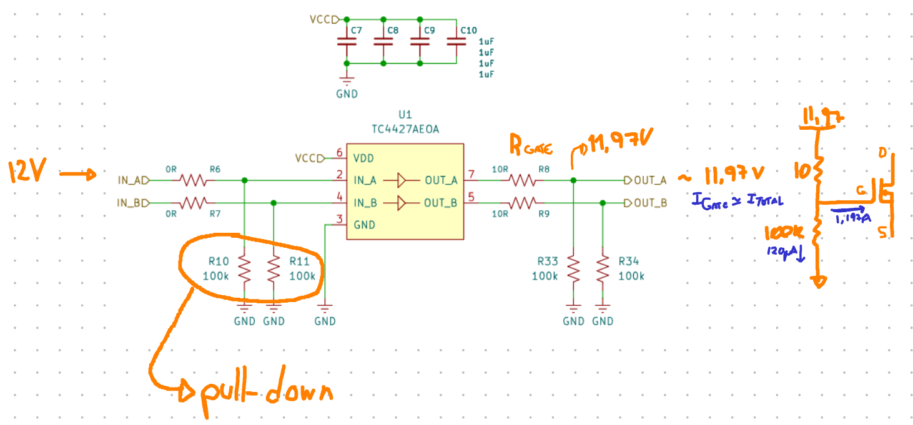
etapa_3/img/diagrama_driver.png
