NivLC/lava_jato/etapa_3/img/diagrama_ldo.png

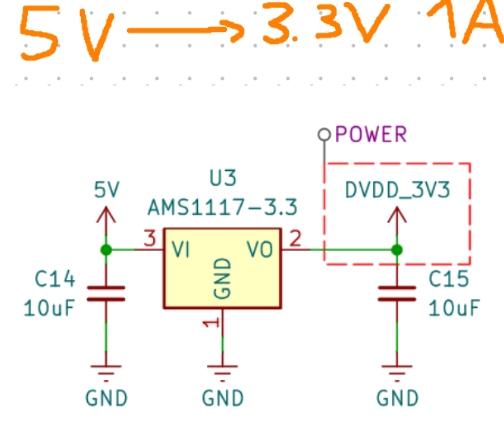
etapa_3/img/diagrama_ldo.png
