NivLC/lava_jato/etapa_3/img/nucleo_d.jpeg

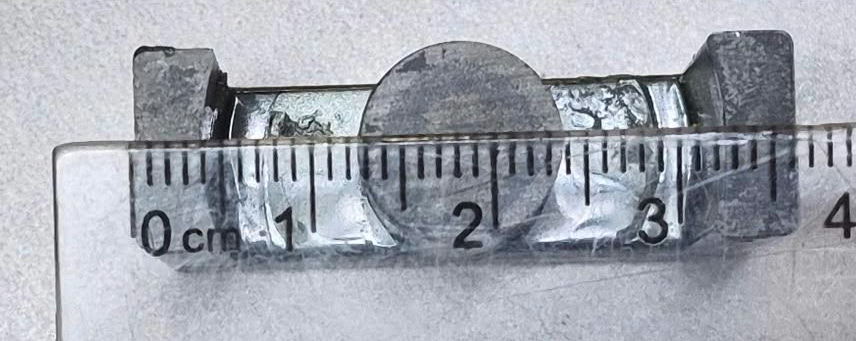
etapa_3/img/nucleo_d.jpeg
