NivLC/lava_jato/etapa_3/img/nucleo_h.jpeg

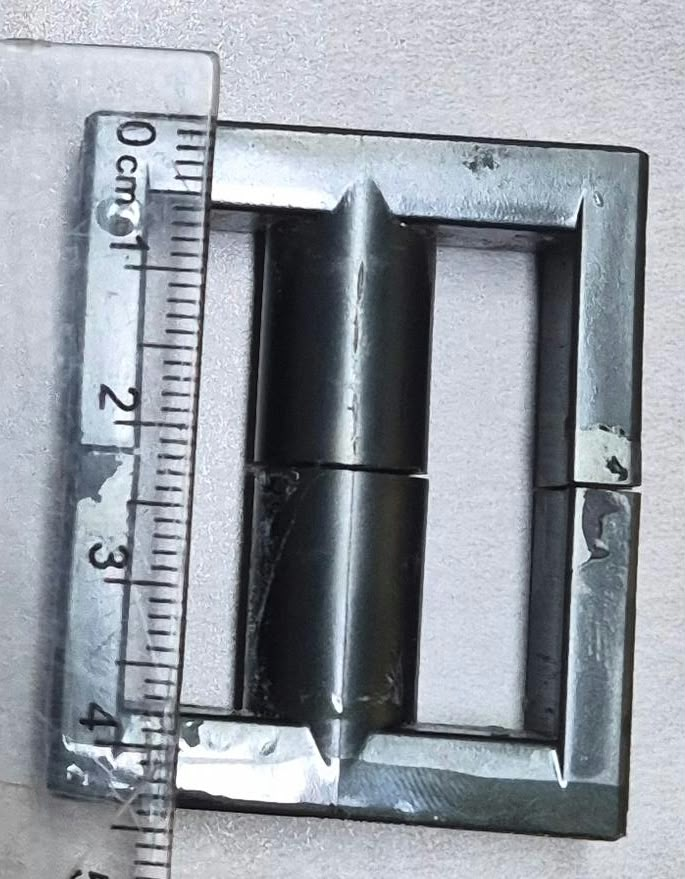
etapa_3/img/nucleo_h.jpeg
