NivLC/lava_jato/etapa_3/hardware/pcb/ultrasonic-cleaner.pdf

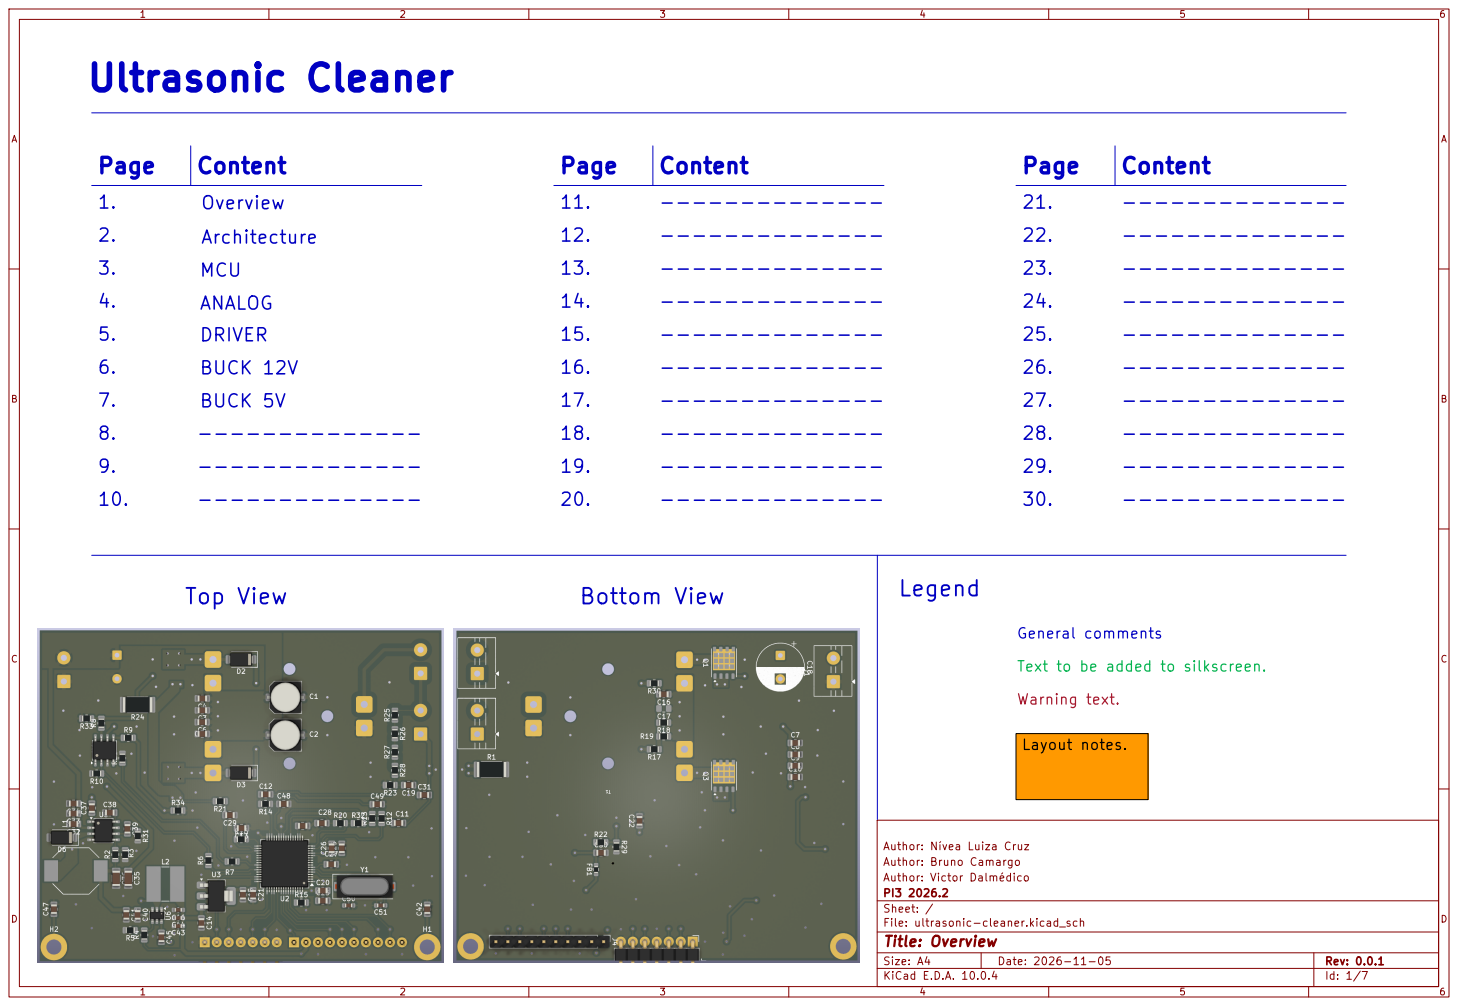
[picture p102: page 1]

Text to be added to silkscreen.

Author: Nívea Luiza Cruz
Author: Bruno Camargo
Author: Victor Dalmédico
Sheet: /
File: ultrasonic-cleaner.kicad_sch
Title: Overview

Size: A4 | Rev: 0.0.1
KiCad E.D.A. 10.0.4 | Id: 1/7

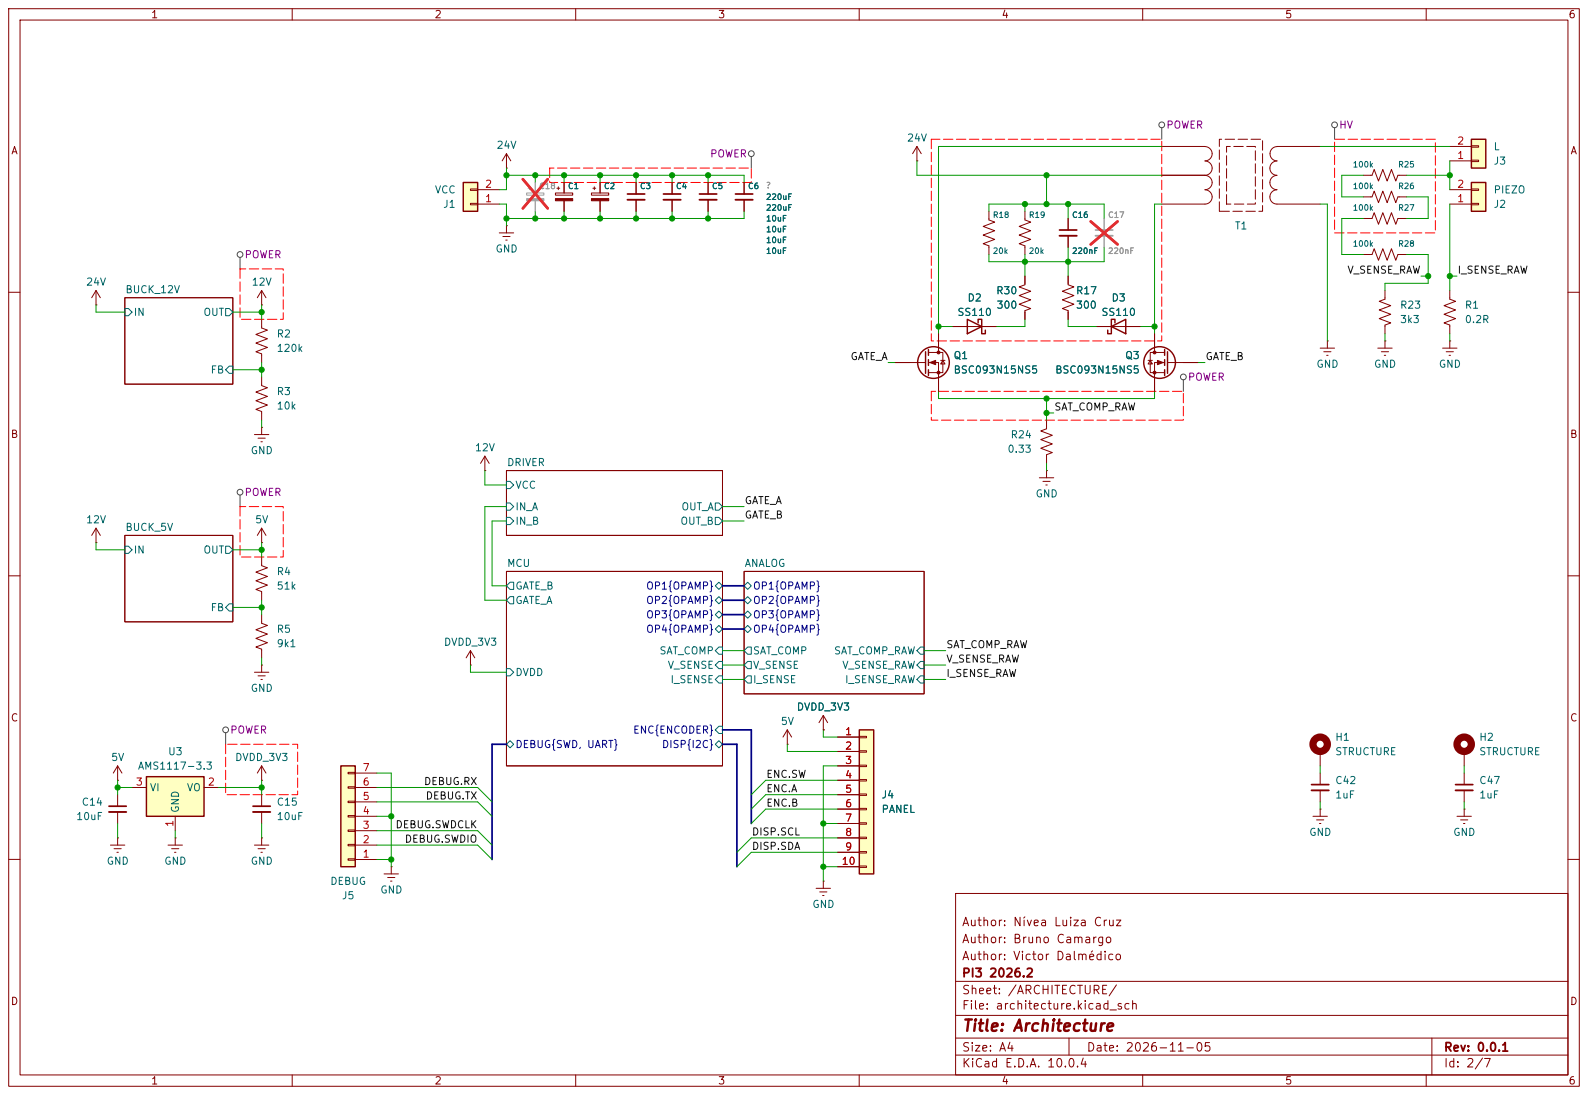
[picture p103: page 2]

DISP.SCL DISP.SDA

Author: Nívea Luiza Cruz
Author: Bruno Camargo
Author: Victor Dalmédico
Sheet: /ARCHITECTURE/
File: architecture.kicad_sch
Title: Architecture

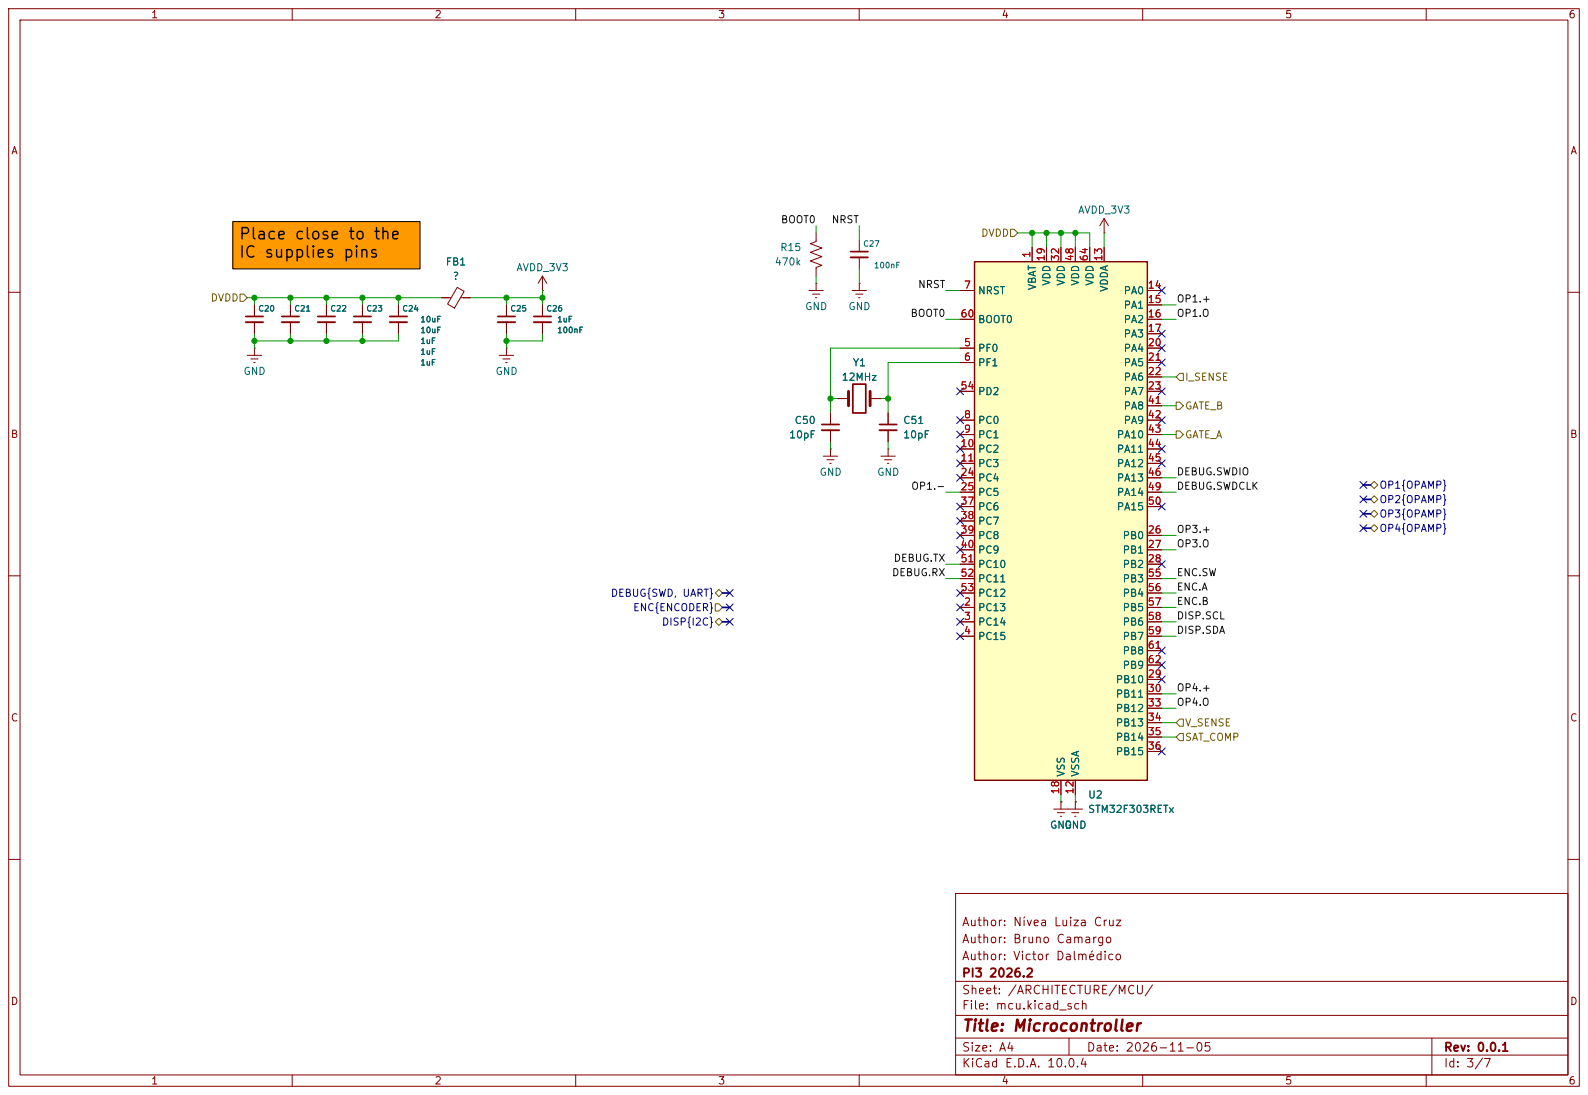
[picture p104: page 3]

OP1.+ Place close to the
IC supplies pins

Author: Nívea Luiza Cruz
Author: Bruno Camargo
Author: Victor Dalmédico
Sheet: /ARCHITECTURE/MCU/
File: mcu.kicad_sch
Title: Microcontroller

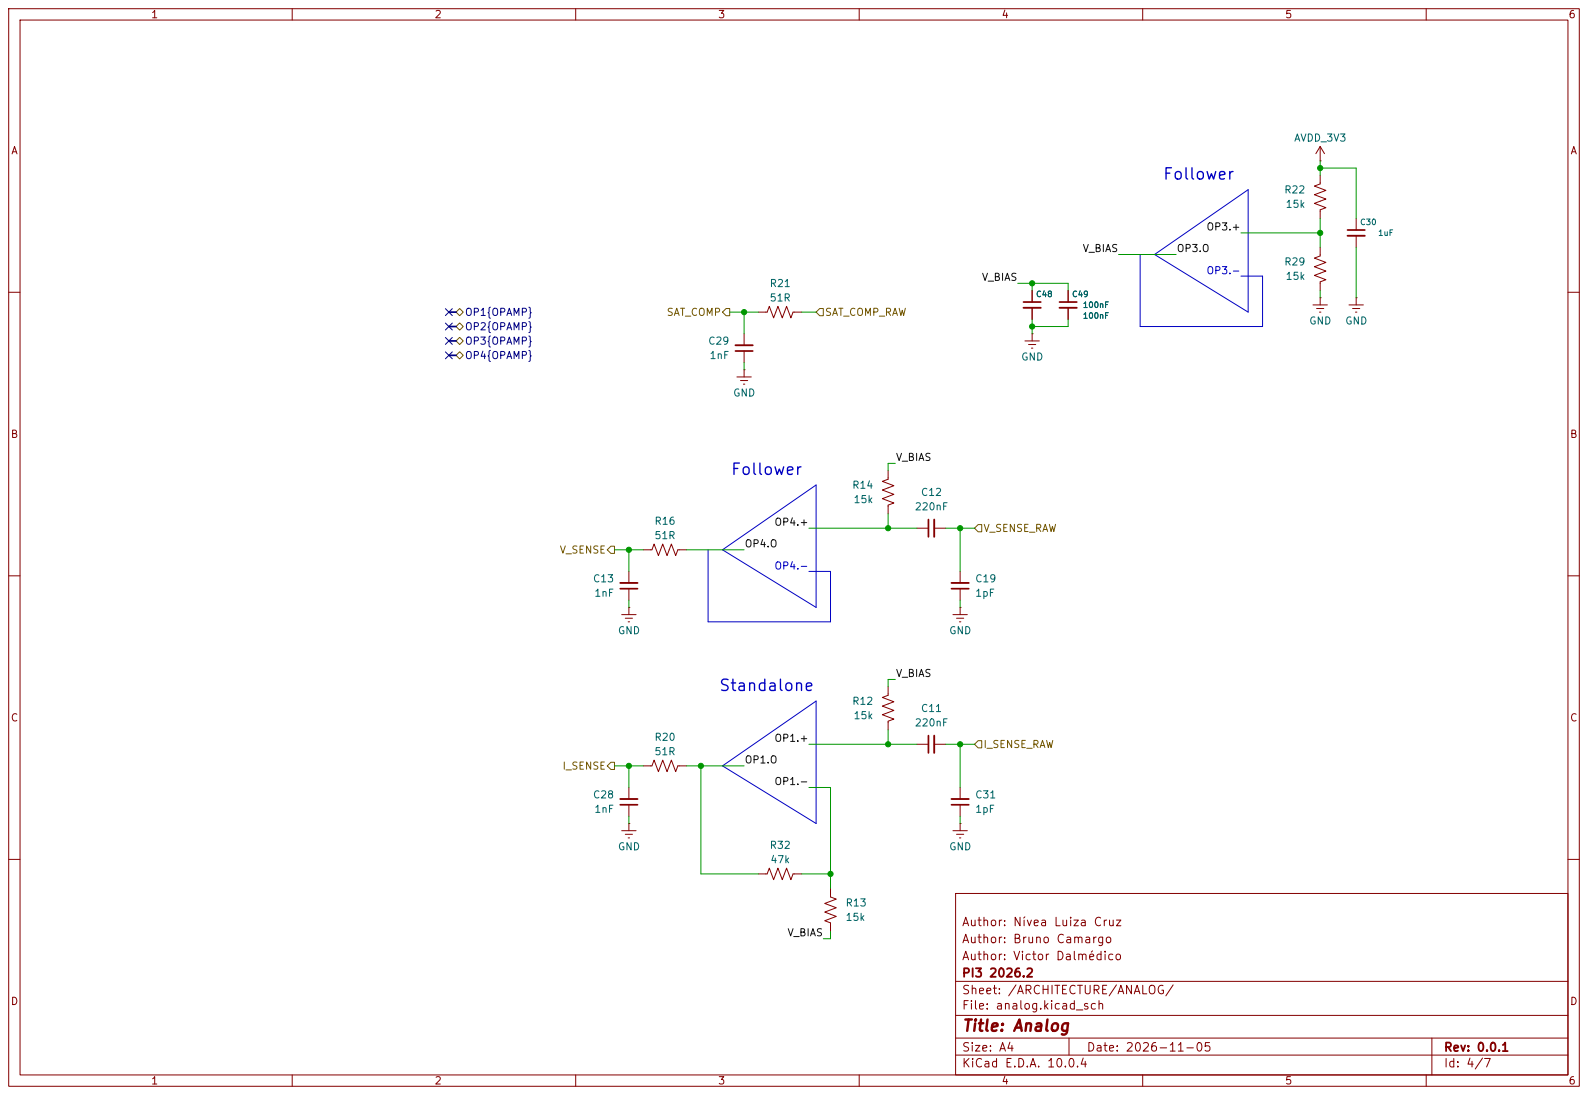
[picture p105: page 4]

Author: Nívea Luiza Cruz C13

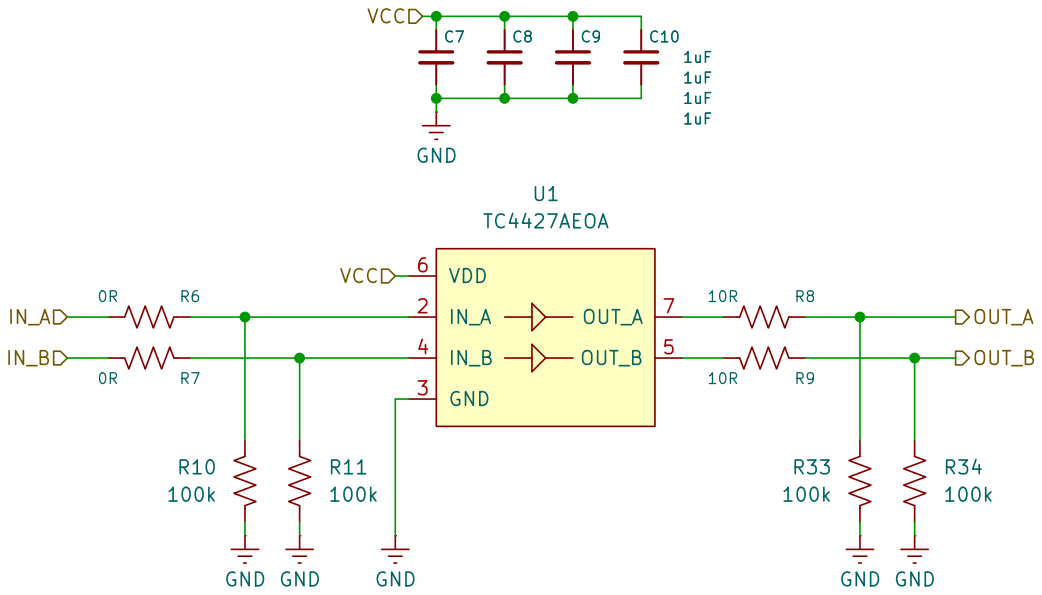
[picture p106: page 5]

Author: Nívea Luiza Cruz R11

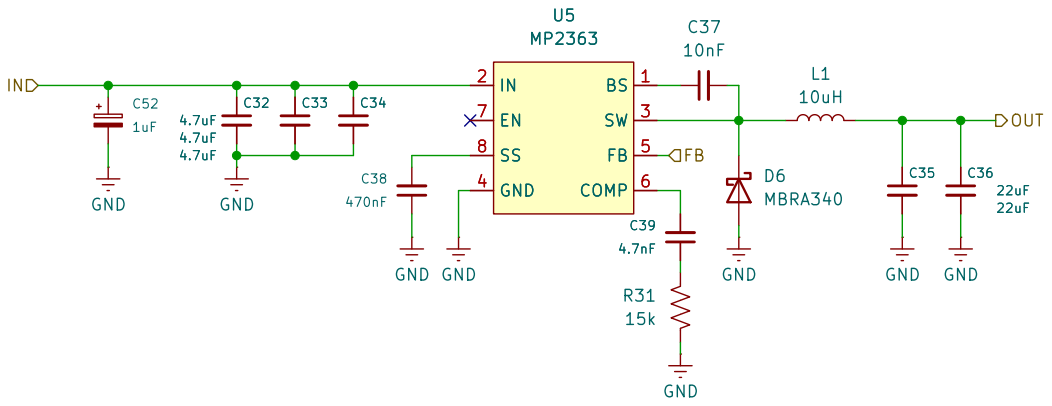
[picture p107: page 6]

Author: Nívea Luiza Cruz
Author: Bruno Camargo
Author: Victor Dalmédico
Sheet: /ARCHITECTURE/BUCK_12V/
File: buck_12v.kicad_sch
Title: Buck 12V

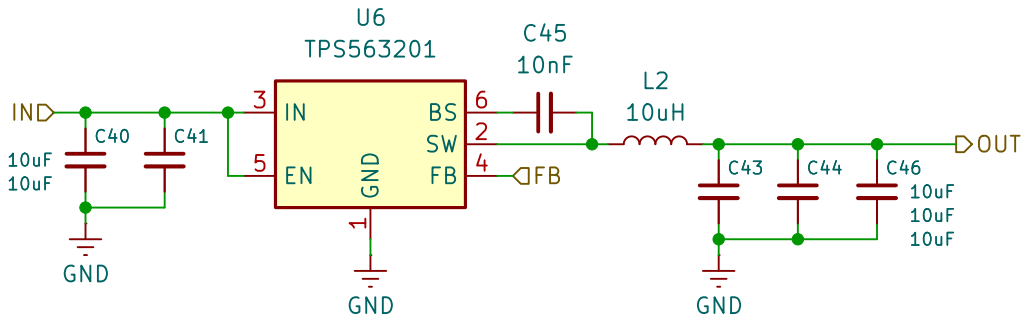
[picture p108: page 7]

Author: Nívea Luiza Cruz GND
