NivLC/lava_jato/etapa_2/hardware/display_pcb/ultrasonic-cleaner-panel.pdf

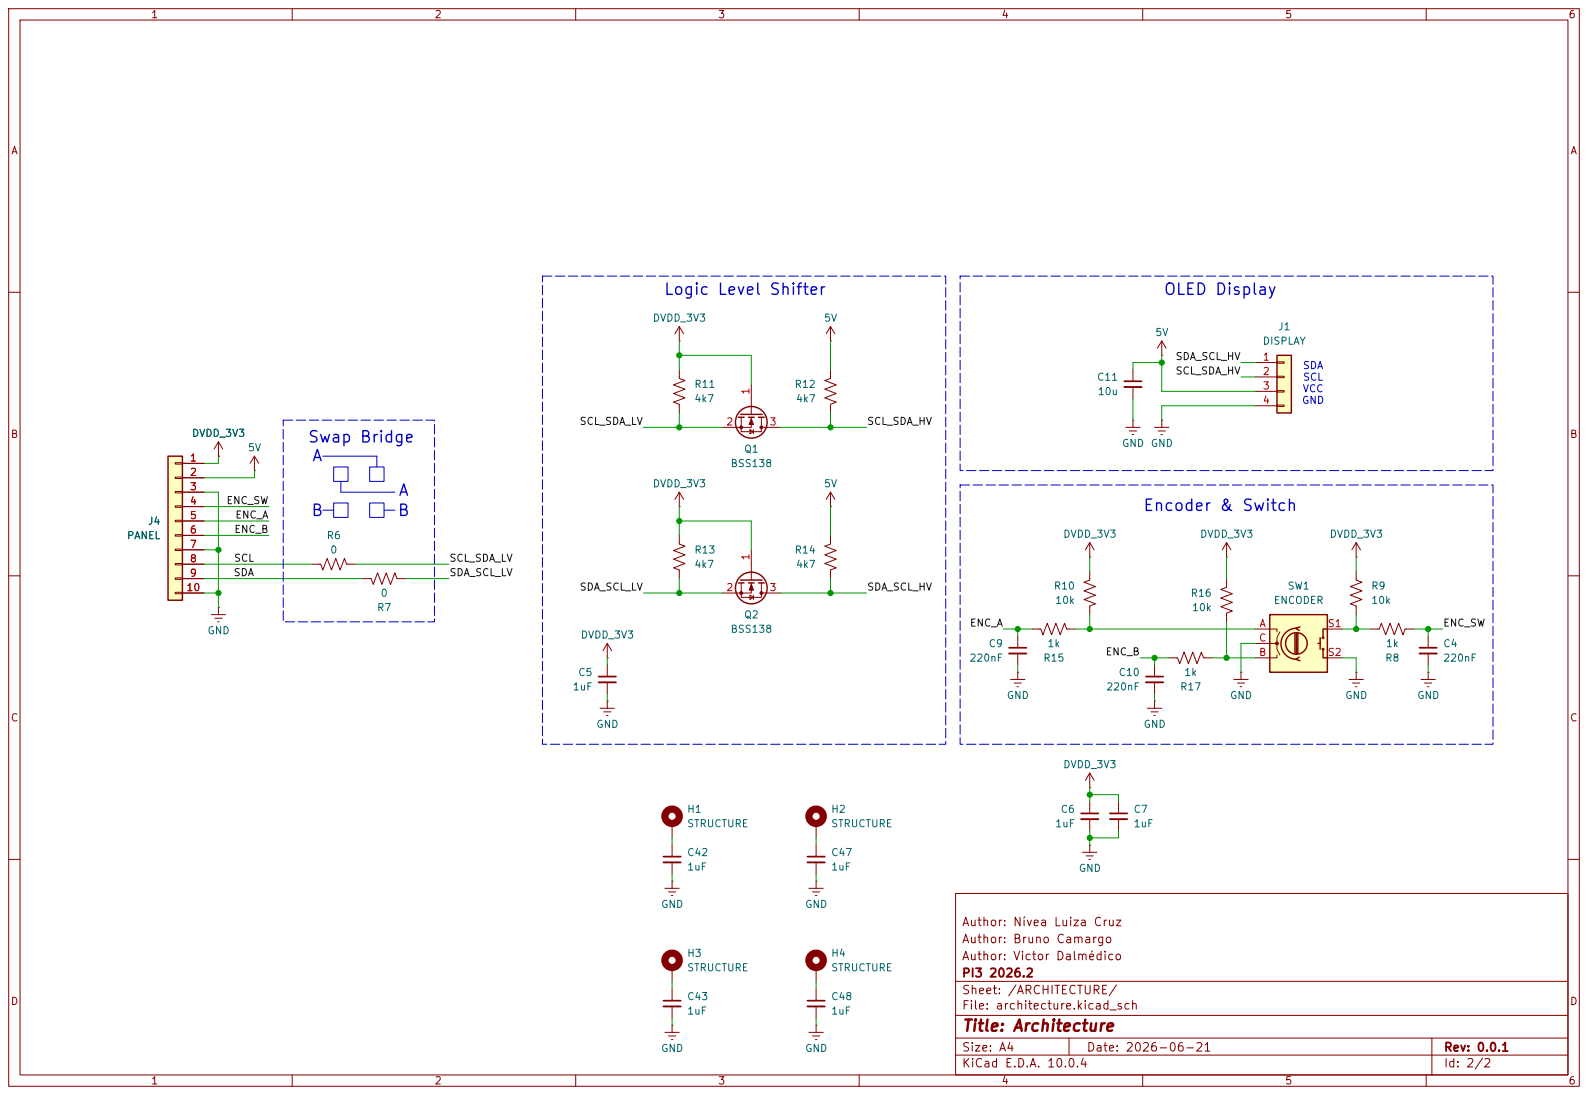
[picture p109: page 1]

Size: A4 | Rev: 0.0.1
KiCad E.D.A. 10.0.4 | Id: 2/2
