NivLC/lava_jato/etapa_3/hardware/trafo/simulacao/trafo_simulado.asc

L1: ind2; 89.65µ; Rser=20m
L2: ind2; 89.65µ; Rser=20m
L3: ind2; 1.946m; Rser=0.2
PWM1: voltage; PULSE(0 5 0 10n 10n 4.5u 10u)
PWM2: voltage; PULSE(0 5 5u 10n 10n 4.5u 10u)
R1: res; 500
R2: res; 10Meg
temp: voltage; 25
U1: TC4427A
U2: TC4427A
U3: BSC093N15NS5
U4: BSC093N15NS5
V1: voltage; 24
V4: voltage; 12
Named nets: 0, PWM1, PWM2, V12, GA, a, b, o, GB, tj, temp
K1 L1 L2 L3 0.9
.tran 0 20u 0 20n
.include TC4427_Rev1_SPICE_Nodel.MOD
.lib OptiMOS5_150V_LTSpice.lib
