NivLC/lava_jato/etapa_3/software/main.c

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
/* Includes ------------------------------------------------------------------*/
#include "main.h"

TIM_HandleTypeDef htim1;

void SystemClock_Config(void);
static void MX_GPIO_Init(void);
static void MX_TIM1_Init(void);
/* USER CODE BEGIN 0 */
void tim_set_pwm_freq(float duty, float freq)
{
  const float timer_clock = 144e6;
  uint32_t arr = timer_clock / (2 * freq);
  uint32_t ccr1 = duty * arr;
  uint32_t ccr3 = arr - ccr1;
  
  __HAL_TIM_SET_AUTORELOAD(&htim1, arr);
  __HAL_TIM_SET_COMPARE(&htim1, TIM_CHANNEL_1, ccr1);
  __HAL_TIM_SET_COMPARE(&htim1, TIM_CHANNEL_3, ccr3);
}
/* USER CODE END 0 */

/**
  * @brief  The application entry point.
  * @retval int
  */
int main(void)
{

  /* MCU Configuration--------------------------------------------------------*/

  /* Reset of all peripherals, Initializes the Flash interface and the Systick. */
  HAL_Init();

  /* Configure the system clock */
  SystemClock_Config();

  /* Initialize all configured peripherals */
  MX_GPIO_Init();
  MX_TIM1_Init();
  /* USER CODE BEGIN 2 */
  //tim_set_pwm_freq(0.40f, 95e3);
  HAL_TIM_PWM_Start(&htim1, TIM_CHANNEL_1);
  HAL_TIM_PWM_Start(&htim1, TIM_CHANNEL_3);

  
  float frequency = 92e3;
  float frequency_step = 125.0f;
  const float duty_cycle = 0.25f;
  /* USER CODE END 2 */

  /* Infinite loop */
  /* USER CODE BEGIN WHILE */
  while (1)
  {
    frequency += frequency_step;
    if (frequency > 101e3)
    {
      frequency_step = -frequency_step;
    }
    if (frequency < 99e3)
    {
      frequency_step = -frequency_step;
    }
    tim_set_pwm_freq(duty_cycle, frequency);
    HAL_Delay(1);
    /* USER CODE END WHILE */

    /* USER CODE BEGIN 3 */
  }
  /* USER CODE END 3 */
}

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
