NivLC/lava_jato/etapa_2/hardware/display_pcb/display_test.ioc

Mcu.UserName=STM32F303RETx
PA10.Signal=S_TIM1_CH3
PA13.Signal=SYS_JTMS-SWDIO
PA14.Signal=SYS_JTCK-SWCLK
PA3.GPIO_Label=HIGH_Z_4
PA3.Signal=GPIO_Input
PA8.Signal=S_TIM1_CH1
PB3.Signal=GPXTI3
PB4.Signal=S_TIM3_CH1
PB5.Signal=S_TIM3_CH2
PB6.Signal=I2C1_SCL
PB7.Signal=I2C1_SDA
PC0.GPIO_Label=HIGH_Z_8
PC0.Signal=GPIO_Input
PC1.GPIO_Label=HIGH_Z_7
PC1.Signal=GPIO_Input
PC10.Signal=USART3_TX
PC11.Signal=USART3_RX
PC13.GPIO_Label=HIGH_Z_3
PC13.Signal=GPIO_Input
PC14-OSC32_IN.GPIO_Label=HIGH_Z_2
PC14-OSC32_IN.Signal=GPIO_Input
PC15-OSC32_OUT.GPIO_Label=HIGH_Z_1
PC15-OSC32_OUT.Signal=GPIO_Input
PC2.GPIO_Label=HIGH_Z_6
PC2.Signal=GPIO_Input
PC3.GPIO_Label=HIGH_Z_5
PC3.Signal=GPIO_Input
PF0-OSC_IN.Signal=RCC_OSC_IN
