NivLC/lava_jato/(commit log)

2026-09-04 Refatoração do texto da Etapa 1 para maior concisão
2026-10-01 Add hardware, software, doc
    [R3k.csv, R3k_axial.csv, R3k_radial.csv, R51.csv, R51_axial.csv, R51_radial.csv, R51_setup.csv]
2026-10-01 Adicionado tópico de design externo
2026-10-01 trava de segurança.md
2026-10-08 Etapa 3 - adição de esqueleto
2026-10-22 Eu tinha explicado o buck12V errado e arrumei.md
2026-10-22 buck 5V.md
2026-10-22 Adicionar arquivos pcb
2026-10-28 feature: adicionado smath para dimensionamento do trafo
2026-10-29 Hotfix: Correção do fator de espiras no smath
2026-11-05 Adição de referência - Mussoi
2026-11-05 produtos de limpeza e materiais de teste.md
