NivLC/lava_jato/(notices)

Notices in the files:
etapa_3/software/main.c:
Copyright (c) 2026 STMicroelectronics.
All rights reserved.
This software is licensed under terms that can be found in the LICENSE file
