NivLC/lava_jato/etapa_3/img/ponte_lcr.jpg

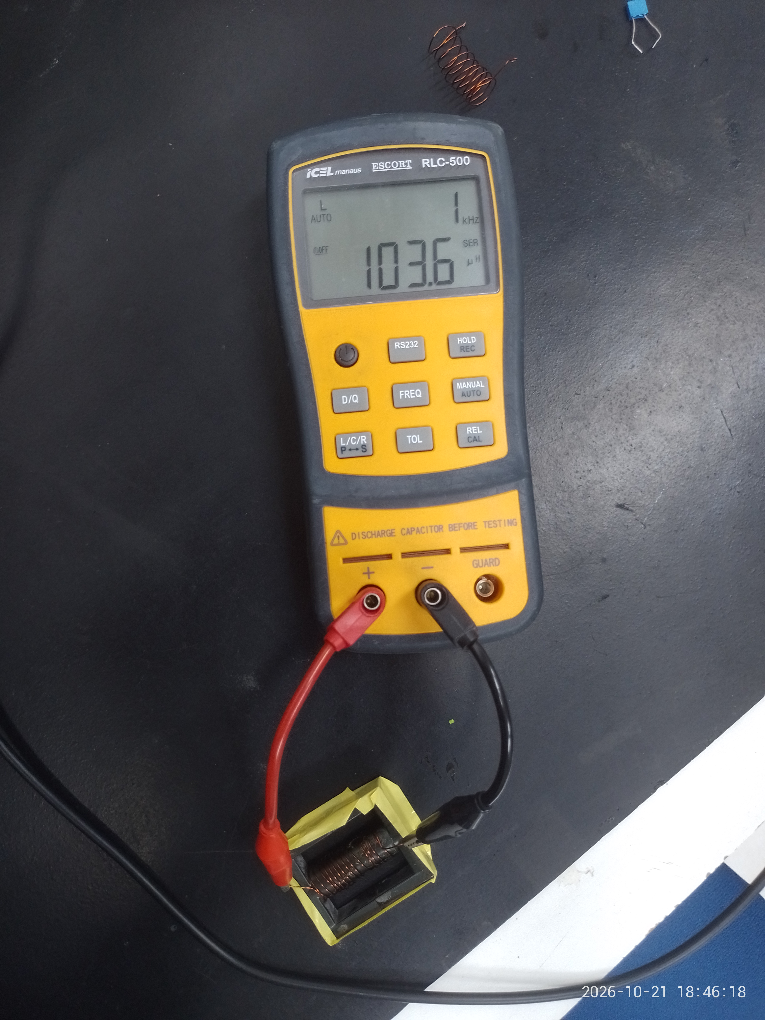
etapa_3/img/ponte_lcr.jpg
